syahrulhuda/EnvironmentalSensing/WHITEBOARD.md

# 📋 WHITEBOARD (The Living Plan & Scratchpad)

Dokumen kerja aktif untuk mencatat fokus berjalan, arsip ide tim, serta evaluasi audit teknis sistem **Smart Environmental Sensing System (ESS)**.

---

# 🎯 Section 1: Current Grand Plan
> [!IMPORTANT]
> **Fokus Utama Saat Ini:** Seluruh integrasi fisik prototipe hardware ESP32-C3 SuperMini (PCB `PCB_ESS_5`, OLED SSD1306, DHT22, MQ-7, MQ-2, Fan PWM SS8050, Filter C1/C2) telah tuntas dan teruji fungsional 100%. Audit keamanan pra-rilis (`PUB-01` s/d `PUB-05`) serta aktivasi GitHub Ruleset (`PUB-06`) telah tuntas diverifikasi empiris. **Zaki & Tim Resmi Menyetujui (APPROVED) Pembukaan Visibilitas Repositori ke Public untuk Portofolio Akademik & Penilaian Dosen Penguji**.
> **Affected Areas:** `hardware/`, `backend/`, `schematics/`, `deploy/`, `.github/workflows/`, `frontend/`.
> **Success Criteria:** 
> 1. Verifikasi offline & online seluruh sensor, OLED, & fan via `prodC3.cpp` (SELESAI - Teruji fisik).
> 2. Proof of concept peredaman noise rangkaian filter C1/C2 (SELESAI - 5.10-5.15V diredam ke 5.13-5.14V).
> 3. Standardisasi kurva & baseline kalibrasi ADC udara bersih MQ-7 (420) & MQ-2 (360) (SELESAI).
> 4. Kompensasi mikroklimat thermal cross-heating DHT22 via `TEMP_OFFSET` (SELESAI).
> 5. Uji inrush current & PWM kipas 4010 via transistor SS8050 & diode 1N4007 (SELESAI - Silent POST 750ms).
> 6. Fabrikasi, perakitan, dan penyolderan PCB single-layer 70x40 mm `PCB_ESS_5` (SELESAI - 100% Operasional).
> 7. Otomasi 3-Tier CI/CD: Pipeline Web Dashboard ke Firebase Hosting (`poltekom-ess.web.app`) via GitHub Actions (SELESAI - Operasional).
> 8. Hardening Keamanan Pra-Publikasi (`PUB-01` s/d `PUB-05`: Rotasi Supabase, Firebase RTDB `.write: auth != null`, Admin Key, Sanitasi CAD) (SELESAI).
> 9. Streamlining firmware ke `hardware/src/prodC3.cpp` & PlatformIO clean build (SELESAI).
> 10. Proteksi branch `main` via GitHub Ruleset aktif (`PUB-06`); Persetujuan publikasi resmi disahkan oleh Zaki (10-Nov-2026); repositori berstatus APPROVED untuk transisi ke Public.

---

# 💡 Section 2: Ideas to Discuss
*Log arsip ide abadi. Jangan menghapus catatan di bagian ini sebagai jejak rekam rekayasa sistem.*

### [Status: DITERIMA] Arsitektur Hybrid Hot-Warm Tiered Storage (RTDB + Supabase)
- **Tanggal & Inisiator:** `[21-09-2026]` - Huda
- **Ide:** Menggabungkan Firebase RTDB sebagai buffer cepat (Hot Storage 2 jam terakhir) dan Supabase PostgreSQL sebagai gudang analitik permanen (Warm Storage).
- **Diskusi:**
  - RTDB gratis memiliki batas 1 GB. Jika menyimpan data per 3 detik selamanya, kuota akan habis dalam beberapa bulan.
  - Dengan membersihkan data lama (> 2 jam) di RTDB dan memadatkannya menjadi agregat 1-menitan di Supabase, kuota RTDB terjaga di bawah 5 MB selamanya, dan Supabase mampu menyimpan data hingga 7 tahun.
- **Keputusan:** `[21-09-2026]` - **[DITERIMA]** Berhasil diuji coba secara fisik dengan 1.661 data mentah terkonversi menjadi 84 baris di PostgreSQL.

### [Status: DITERIMA] FIFO Continuous Sliding Window 2 Jam di RTDB
- **Tanggal & Inisiator:** `[22-09-2026]` - Huda
- **Ide:** Mekanisme pemangkasan (*pruning*) RTDB tidak boleh menghapus seluruh data secara berkala (*flush & refill*), melainkan mempertahankan rentang waktu bergerak 2 jam terakhir (`now - 2 hours`) secara kontinu.
- **Diskusi:**
  - Jika data dihapus total, pengguna yang mengakses chatbot sesaat setelah pembersihan akan kehilangan konteks data.
  - Dengan menghapus hanya record dengan `created_at < (now - 2 jam)`, data 2 jam terakhir selalu siap diakses setiap milidetik.
- **Keputusan:** `[22-09-2026]` - **[DITERIMA]** Diadopsi sebagai standar algoritma pruning ETL.

### [Status: DITERIMA] Flutter sebagai Thin Client Multiplatform (Web & Mobile)
- **Tanggal & Inisiator:** `[22-09-2026]` - Pak Amin & Huda
- **Ide:** Antarmuka pengguna dibangun menggunakan Flutter agar dari satu basis kode dapat dihasilkan versi Web (Firebase Hosting) dan versi Android (.apk). Seluruh logika berat dan kunci API diisolasi di backend FastAPI (Raspberry Pi 3B On-Premise via Cloudflare Tunnel / Ngrok).
- **Keputusan:** `[22-09-2026]` - **[DITERIMA]** Diadopsi untuk layer antarmuka pengguna.

### [Status: DITERIMA] Isolasi Kredensial Hardware via secrets.h (Compile-Time)
- **Tanggal & Inisiator:** `[24-09-2026]` - Huda
- **Ide:** Kredensial Wi-Fi dan token perangkat keras dipisahkan ke dalam file `secrets.h` lokal yang diabaikan oleh `.gitignore`. Repositori Git hanya menyimpan `secrets.example.h`.
- **Keputusan:** `[24-09-2026]` - **[DITERIMA]** Diadopsi untuk menjamin zero credential leakage di GitHub publik tanpa membebani flash NVS mikrokontroler.

### [Status: DITERIMA] Self-Hosting Backend di Raspberry Pi 3B On-Premise
- **Tanggal & Inisiator:** `[24-09-2026]` - Huda
- **Ide:** Menjalankan backend FastAPI, APScheduler, dan ESI AI Agent secara mandiri 24/7 di Raspberry Pi 3B (1 GB RAM, 16 GB MicroSD) di laboratorium POLTEKOM dengan daemon systemd `ess-backend.service`.
- **Diskusi:**
  - Mengeliminasi kebutuhan kartu kredit pada cloud hosting publik (Render).
  - Konsumsi memori sangat hemat (~100 MB dari 1.000 MB RAM terpakai).
  - MicroSD aman dari kerusakan (wear-out) karena data mentah dan analitik tetap disimpan di Firebase RTDB & Supabase PostgreSQL (arsitektur Hybrid).
- **Keputusan:** `[24-09-2026]` - **[DITERIMA]** Diadopsi sebagai blueprint backend on-premise utama.

### [Status: DITERIMA] Ngrok Free Static Domain sebagai Solusi Zero-Cost Tunnel Tanpa Custom Domain
- **Tanggal & Inisiator:** `[25-09-2026]` - Huda
- **Ide:** Menggunakan Ngrok Free Tier untuk mendapatkan 1 Static Domain permanen gratis selamanya (`entrap-glamour-spectrum.ngrok-free.dev`) tanpa perlu membeli custom domain dan tanpa kartu kredit. Dijalankan sebagai daemon systemd `ess-tunnel.service` di Raspberry Pi 3B.
- **Diskusi:**
  - Cloudflare Named Tunnel mewajibkan kepemilikan domain pribadi yang diarahkan ke NS Cloudflare.
  - Ngrok memberikan 1 static domain permanen gratis tanpa domain pribadi, langsung tembus NAT/firewall kampus POLTEKOM via HTTPS aman.
- **Keputusan:** `[25-09-2026]` - **[DITERIMA]** Diadopsi sebagai public API gateway endpoint resmi untuk client frontend.

### [Status: DITERIMA & SELESAI] Perbaikan Multi-turn Conversation & Dukungan Riwayat Chat ESI
- **Tanggal & Inisiator:** `[28-09-2026]` - Huda & Zaki
- **Ide:** Memperbaiki penanganan konteks percakapan multi-turn di mana frontend (Web & Flutter) mengelola array riwayat pesan (`history`) dan mengirimkannya bersama prompt user ke `POST /api/chat`, sementara backend Gemini mengonversi riwayat tersebut ke dalam session context.
- **Keputusan:** `[28-09-2026]` - **[DITERIMA & IMPLEMENTED DI BACKEND & FRONTEND]** Huda telah mengimplementasikan fungsi `_sanitize_history()` dan passing riwayat ke `model.start_chat()` di `ai_service.py` lengkap dengan skema `ChatMessage` di `routes.py`. Zaki telah mengintegrasikan state tracking di sisi frontend.

### [Status: DITERIMA & SELESAI] Ekspansi REST API Endpoints Backend untuk Kesiapan Flutter Dashboard
- **Tanggal & Inisiator:** `[28-09-2026]` - Huda & Zaki
- **Ide:** Menambahkan endpoint `GET /api/telemetry/latest` dan `GET /api/logs` di FastAPI agar Flutter memiliki opsi single-gateway tanpa harus bergantung pada banyak SDK database di sisi client.
- **Keputusan:** `[28-09-2026]` - **[DITERIMA & IMPLEMENTED DI BACKEND]** Huda telah menambahkan endpoint `GET /api/telemetry/latest` dan `GET /api/logs` di `routes.py`, siap dikonsumsi langsung oleh Flutter Thin Client.

### [Status: DITERIMA] Standarisasi Header Bypass Ngrok pada Client Frontend
- **Tanggal & Inisiator:** `[28-09-2026]` - Huda & Zaki
- **Ide:** Mewajibkan penyisipan header `'ngrok-skip-browser-warning': 'true'` pada setiap HTTP request dari Web dan Flutter ke domain tunnel publik untuk mencegah pencegatan halaman HTML Ngrok Free.
- **Keputusan:** `[28-09-2026]` - **[DITERIMA & TERAPKAN]** Header bypass resmi diterapkan di `frontend/app.js` dan Flutter `esi_chat_service.dart`.

### [Status: DITERIMA] Penanganan Latensi ReAct AI & UX Loading State pada Frontend Client
- **Tanggal & Inisiator:** `[28-09-2026]` - Huda & Zaki
- **Ide:** Menyetel HTTP timeout minimal 15–20 detik dan mengimplementasikan indikator visual loading/typing bubble di UI Flutter/Web selama proses ReAct Function Calling berlangsung (2–5 detik).
- **Keputusan:** `[28-09-2026]` - **[DITERIMA & TERAPKAN]** Timeout 20 detik dan animasi loading "ESI sedang menganalisis sensor..." telah terpasang di antarmuka Web dan Flutter.

### [Status: DITERIMA & SELESAI] Konfigurasi PYTHONUNBUFFERED=1 pada Service Daemon Systemd Raspi
- **Tanggal & Inisiator:** `[28-09-2026]` - Huda
- **Ide:** Mencegah output log ETL tertahan di block buffer 4KB Python saat berjalan sebagai daemon background systemd di Raspi.
- **Keputusan:** `[30-09-2026]` - **[DITERIMA & AKTIF]** `Environment=PYTHONUNBUFFERED=1` telah terpasang dan diverifikasi aktif di daemon systemd Raspberry Pi serta template setup.

### [Status: DITERIMA] Sistem Aspirasi Gas Terowongan Manifold Bertekanan Negatif (Negative Pressure Exhaust)
- **Tanggal & Inisiator:** `[01-10-2026]` - Zaki
- **Ide:** Menambahkan terowongan/ducting sampling dengan kipas hisap (*exhaust blower fan*) yang diletakkan di **belakang** sensor MQ-7 dan MQ-2 (sistem tekanan negatif). Udara dari area bengkel disedot melalui corong/pipa menuju ruang sensor (*chamber*), lalu dibuang keluar melewati kipas.
- **Diskusi & Pertimbangan Rekayasa:**
  1. *Kecepatan Deteksi Jarak Jauh:* Menghilangkan ketergantungan pada difusi udara pasif, sehingga asap/gas CO dari meja las/solder dapat dideteksi dalam hitungan detik meski alat diletakkan pada jarak tertentu.
  2. *Proteksi Pemanas Sensor (Anti Heat Quenching):* Menempatkan kipas di ujung buang (*pull mode*) menghasilkan aliran laminer yang merata di sekitar sensor. Kipas dilarang meniup langsung ke kubah kawat sensor agar elemen pemanas $SnO_2$ (300°C–400°C) tidak dingin yang dapat merusak akurasi ADC.
  3. *Tipe Kipas:* Menggunakan Kipas Blower Sentrifugal / Keong (*Brushless DC / BLDC* ukuran 5015 atau 4020 atau 3010) bertekanan statis tinggi, bebas percikan api komutator (aman untuk deteksi gas mudah terbakar MQ-2).
  4. *Kendali Daya:* Dikendalikan via modul switching MOSFET/Transistor terhubung ke GPIO ESP32 (PWM / Otomatisasi mode sampling).
- **Keputusan:** `[01-10-2026]` - **[DITERIMA]** Disepakati sebagai arsitektur enclosure & sampling fisik resmi untuk node hardware.

### [Status: ROADMAP / PENDING] Zero-Trust Device Claiming & Quarantine Approval via Flutter Admin
- **Tanggal & Inisiator:** `[24-09-2026]` - Huda
- **Ide:** Untuk mencegah perangkat palsu / rogue MAC membanjiri database Supabase, setiap node baru yang terdeteksi akan masuk ke status `QUARANTINE / PENDING`. Pengawas bengkel harus menekan tombol "Approve / Claim" di aplikasi Flutter sebelum data node tersebut dimasukkan ke analitik ESS utama.
- **Diskusi:**
  - Menghindari kerentanan MAC spoofing dan menjamin integritas data ESS.
- **Keputusan:** `[24-09-24]` - **[PENDING - ROADMAP]** Akan diimplementasikan saat fondasi antarmuka Flutter mulai dibangun.

### [Status: IMPLEMENTED - TAHAP 1 SELESAI] 3-Tier Multiplatform CI/CD Pipeline & In-App OTA Update Engine
- **Tanggal & Inisiator:** `[29-10-2026]` - Huda
- **Latar Belakang & Filosofi Zero-Manual-Ops:**
  - Tidak ada tim DevOps khusus dalam proyek ini; seluruh infrastruktur dan delivery sistem dipelihara mandiri secara otomatis, aman, dan *zero-touch*.
  - Mengeliminasi beban operasional berulang: tidak perlu SSH manual ke Raspberry Pi untuk menarik kode (`git pull`) dan restart service, tidak perlu kompilasi manual Flutter Web di lokal, serta tidak memaksa pengguna mobile mengunduh ulang APK secara manual dari browser setiap ada pembaruan fitur.
- **Arsitektur 3 Pipeline Utama:**
  1. **Pipeline 1: Backend Continuous Deployment ke Raspberry Pi 3B On-Premise via GitHub Self-Hosted Runner**
     - **Tantangan Lingkungan Edge:** Raspberry Pi 3B berada di balik NAT dan firewall kampus POLTEKOM tanpa IP publik statis. Port 22 SSH tidak dapat dijangkau oleh runner cloud GitHub Actions tanpa VPN/tunnel khusus yang rentan terputus.
     - **Solusi Arsitektur:** Memasang daemon `actions-runner` (GitHub Self-Hosted Runner) langsung di dalam Raspberry Pi 3B, didaftarkan sebagai daemon systemd (`actions.runner.*.service`).
     - **Mekanisme Polling Outbound:** Runner lokal melakukan *long polling* keluar (outbound HTTPS port 443) ke GitHub, sehingga sama sekali **tidak membutuhkan port inbound terbuka** di router/firewall kampus.
     - **Workflow (`.github/workflows/deploy-backend.yml`):**
       - *Trigger:* `push` ke branch `main` pada path `backend/**` atau `deploy/**`.
       - *Stage 1 (Cloud CI - `ubuntu-latest`):* Menjalankan linting (flake8/ruff) dan pengujian otomatis (Pydantic schema validation, mock ETL, mock ReAct) di cloud runner agar tidak membebani komputasi Raspi (1 GB RAM).
       - *Stage 2 (Edge CD - `runs-on: [self-hosted, raspi3b]`):* Setelah Stage 1 lulus, runner lokal Raspi otomatis mengeksekusi pipeline:
         ```bash
         cd /home/pi/environmentalsensing/backend
         git pull origin main
         source venv/bin/activate && pip install -r requirements.txt
         sudo systemctl restart ess-backend.service
         curl -f http://127.0.0.1:8000/api/telemetry/latest || exit 1
         ```
  2. **Pipeline 2: Web App Continuous Deployment ke Firebase Hosting — [SELESAI & OPERASIONAL]**
     - **Lingkungan Kompilasi:** GitHub-hosted runner `ubuntu-latest` (Node 20 LTS).
     - **Workflow (`.github/workflows/deploy-web.yml`):**
       - *Trigger:* `push` ke branch `main` pada path `frontend/**`, `firebase.json`, `.firebaserc`, atau file workflow.
       - *Mekanisme Autentikasi:* Menggunakan Google Application Default Credentials (`GOOGLE_APPLICATION_CREDENTIALS`) dengan secret terenkripsi `FIREBASE_SERVICE_ACCOUNT` di GitHub Repository Secrets. Kredensial sementara ditulis ke `$RUNNER_TEMP/sa.json` dan langsung dihapus setelah deploy.
       - *Target Site:* Multi-site Firebase `poltekom-ess` (`https://poltekom-ess.web.app`) pada project `environmental-sensing-f6e1c`.
       - *Waktu Delivery:* ~1-2 menit secara otomatis tanpa intervensi manual.
  3. **Pipeline 3: Mobile Android APK CI & In-App OTA (Over-The-Air) Update Engine**
     - **Tantangan Distribusi Non-PlayStore:** Aplikasi mobile ESS didistribusikan secara internal tanpa Google Play Store ($25 fee & review time). Jika ada rilis baru, pengguna enggan repot mengunduh ulang file APK melalui web browser.
     - **Automated Build & Release Workflow (`.github/workflows/release-mobile.yml`):**
       - *Trigger:* Pembuatan git tag rilis versi (contoh: `git tag v1.2.0 && git push origin v1.2.0`).
       - Cloud runner mengeksekusi `flutter build apk --release` -> Mengunggah artifact `app-release.apk` ke GitHub Releases publik secara otomatis.
     - **In-App OTA Engine (Sisi Flutter Mobile):**
       - Flutter client menggunakan `package_info_plus` untuk mendeteksi versi aplikasi lokal yang sedang berjalan (`currentVersion`).
       - Setiap kali aplikasi dibuka (*cold start*), service melakukan pengecekan ke endpoint backend: `GET /api/app/version`.
       - *Payload Respon Backend:*
         ```json
         {
           "latest_version": "1.2.0",
           "min_required_version": "1.0.0",
           "download_url": "https://github.com/mrzakist/environmentalsensing/releases/download/v1.2.0/app-release.apk",
           "release_notes": "Optimasi kalibrasi zero-baseline MQ-2 & responsivitas layout chat ESI.",
           "force_update": false
         }
         ```
       - Jika `latest_version > currentVersion`, aplikasi memunculkan dialog pembaruan (`UpdateAvailableDialog`):
         - Menampilkan changelog fitur terbaru.
         - Tombol *"Perbarui Sekarang"* mengunduh APK ke penyimpanan lokal via background downloader dan memicu Android `PackageInstaller` intent untuk instalasi langsung tanpa membuka browser.
- **Keputusan:** `[29-10-2026]` - **[DITERIMA & LENGKAP 100%]** Seluruh 3-Tier Pipeline (Pipeline 1: Edge Raspi CD via Self-Hosted, Pipeline 2: Web Dashboard ke Firebase Hosting, dan Pipeline 3: Mobile OTA & GitHub Release via `.github/workflows/release-mobile.yml`) telah beroperasi penuh dan terverifikasi.
### [Status: DITERIMA & SELESAI] Hasil Uji Empiris Rangkaian Filter Daya C1/C2 (Proof of Concept)
- **Tanggal & Inisiator:** `[09-10-2026]` - Huda
- **Ide & Pengujian:** Menguji rangkaian low-pass / decoupling filter daya input (C1 Elco 100uF + C2 Keramik 100nF + KF301-2P) menggunakan sumber daya 5V dari pin VIN ESP32 WROOM sebelum pemasangan barrel jack DC permanen.
- **Hasil Pengukuran Multimeter:**
  - Tegangan input dari rail 5V berfluktuasi pada rentang `5.10 - 5.15 V` (ripple ~50 mV).
  - Tegangan output pada screw terminal KF301 terukur sangat stabil di `5.13 - 5.14 V` (ripple hanya ~10 mV).
  - Gejala *RC discharging* teramati saat daya diputus (tegangan turun perlahan), membuktikan elco C1 aktif menyimpan muatan sebagai bulk energy buffer lokal untuk menyerap inrush current.
- **Keputusan:** `[09-10-2026]` - **[TERBUKTI SECARA EMPIRIS]** Desain filter catu daya `PCB_ESS_5` dinyatakan paten dan valid untuk peredaman noise switching/transient.

### [Status: DITERIMA & SELESAI] Kalibrasi Zero-Baseline Udara Bersih Sensor Gas MQ-7 & MQ-2
- **Tanggal & Inisiator:** `[09-10-2026]` - Huda
- **Temuan Fisik:** Setelah pemanasan kontinu >1 jam (1670+ sampel) di udara bersih ber-AC, modul MQ-7 fisik menghasilkan tegangan idle stabil pada `1.24 - 1.25 V` (ADC ~1545-1550), sementara MQ-2 stabil pada `0.36 - 0.39 V` (ADC ~450-475). Rumus linier awal `map(adc, 400, ...)` menyebabkan false warning 127 ppm di kamar normal.
- **Keputusan Arsitektur:** Menetapkan nilai baseline udara bersih `#define MQ7_BASELINE_ADC 1550` dan `#define MQ2_BASELINE_ADC 460` di firmware `tes_c3.ino` dan `main.cpp`. Nilai ADC di bawah atau sama dengan baseline dipetakan ke 5 ppm (kondisi aman / NORMAL, LED Hijau Solid).

### [Status: DITERIMA & SELESAI] Mitigasi Thermal Cross-Heating DHT22 dari Pemanas Sensor MQ
- **Tanggal & Inisiator:** `[09-10-2026]` - Huda
- **Analisis Masalah:** Sensor DHT22 membaca suhu 29 - 33 C meskipun berada di ruangan ber-AC (suhu riil ~26 C). Fenomena ini teridentifikasi sebagai *thermal cross-heating* akibat koil pemanas internal MQ-2 dan MQ-7 yang mendisipasikan daya termal ~1.5 Watt ke area sekitarnya pada breadboard.
- **Keputusan:**
  1. Di sisi firmware: Ditambahkan konstanta kompensasi `#define TEMP_OFFSET 0.0` (dapat diset misal `-3.0` jika offset termal konstan).
  2. Di sisi mekanikal/enclosure: DHT22 wajib diberi jarak fisik minimal 2 - 3 cm dari modul MQ pada casing akrilik atau dipisahkan oleh aliran angin intake tunnel.

### [Status: DITERIMA & SELESAI] Penanganan Flapping USB ESP32-C3 SuperMini via Download Mode (BOOT+RST)
- **Tanggal & Inisiator:** `[09-10-2026]` - Huda
- **Masalah:** Saat pertama kali dicolokkan ke laptop via kabel USB-C, koneksi USB ESP32-C3 SuperMini mengalami flapping (putus-nyambung berulang) akibat loop crash firmware bawaan atau status ROM bootloader yang tidak stabil.
- **Solusi Operasional:** Menahan tombol **BOOT** (GPIO 9), menekan tombol **RST** satu kali, lalu melepas tombol **BOOT**. Trik ini memaksa SoC masuk ke *ROM Download Boot Mode*, menstabilkan enumerasi USB CDC Serial di Device Manager / Arduino IDE (`COM8`). Setelah diflash dengan parameter `USB CDC On Boot: Enabled` dan `Flash Mode: DIO`, board booting stabil seterusnya.

### [Status: DITERIMA & SELESAI] Arsitektur Responsif Pinned Chat Panel (Opsi A Web / Opsi B Mobile) & Palet 4-Warna
- **Tanggal & Inisiator:** `[27-10-2026]` - Huda
- **Ide:** Menghilangkan kelebihan variasi warna (*color clutter*) dengan merampingkan UI menjadi 4 token semantik utama: Primary (#0284C7 Slate Cyan), Secondary (#0F172A/#1E293B Dark Slate Surface/Card), Tertiary (#94A3B8 Muted Text/Border), dan Accent (#10B981 Neon Mint / Safe Emerald), dengan warna peringatan bahaya K3 (Merah & Amber) aktif murni secara kondisional saat insiden bahaya. Sekaligus menghadirkan tata letak responsif adaptif:
  - **Opsi A (Web/Desktop, width > 900px):** Split-view di mana kolom kiri (metriks dan grafik) dapat di-scroll vertikal, sementara kolom kanan memuat `EsiChatPanel` yang dipin (*stay in place*) setinggi viewport tanpa ikut ter-scroll keluar layar.
  - **Opsi B (Mobile, width <= 900px):** Tampilan satu kolom dengan *floating action button* yang memicu *docked modal bottom sheet*.
- **Keputusan:** `[27-10-2026]` - **[DITERIMA & IMPLEMENTED LENGKAP]** Diimplementasikan di `app_colors.dart`, `esi_chat_panel.dart`, `esi_chat_bottom_sheet.dart`, dan `dashboard_screen.dart` dengan auto-scroll bottom frame listener.

### [Status: DITERIMA & SELESAI] Arsitektur I2C Bus Recovery (9 SCL Pulses) & Runtime Self-Healing OLED
- **Tanggal & Inisiator:** `[10-11-2026]` - Huda & Zaki
- **Masalah:** Pada implementasi PCB fisik, modul OLED SSD1306 terkadang mengalami ketidakstabilan (kadang tidak menyala saat boot) akibat inrush transient driver kipas dan potensi I2C bus lockup di mana OLED menahan jalur SDA LOW saat ESP32 me-reset.
- **Solusi Rekayasa:**
  1. *Prioritas Inisialisasi Bersih:* OLED diinisialisasi pertama kali pada startup sebelum driver motor/kipas aktif.
  2. *9 SCL Clock Pulses Recovery (`recoverI2CBus()`):* Sebelum `Wire.begin()`, firmware mengecek status SDA. Jika LOW, ESP32 memompa 9 pulsa clock SCL dan mengirim sinyal STOP I2C kondisional untuk memaksa slave melepas bus.
  3. *Mekanisme Self-Healing Non-Blocking:* Jika layar sempat terlepas atau mengalami error I2C di runtime, fungsi `updateOledDisplay()` secara otomatis mencoba re-inisialisasi bus tiap 5 detik tanpa membekukan loop utama.
  4. *Silent & Swift POST (~750 ms):* Uji mandiri lampu RGB (450ms) dan sentakan kipas halus (300ms @ duty 40%) menggantikan raungan bising 4,4 detik lama.
  5. *Warmup Shield 15 Detik:* Waktu pemanasan sensor gas diselaraskan dari 45s ke 15s.
- **Keputusan:** `[10-11-2026]` - **[DITERIMA & IMPLEMENTED DI PRODC3.CPP]** Berhasil diuji fisik dan terbukti membuat OLED langsung aktif 100% stabil.

### [Status: DITERIMA & SELESAI] Konsolidasi Single Source of Truth Firmware (`prodC3.cpp`) & PlatformIO Streamlining
- **Tanggal & Inisiator:** `[10-11-2026]` - Huda
- **Masalah:** Duplikasi dua berkas produksi (`main.cpp` di `src/` dan `prodC3.ino` di `prod/prodC3/`) menimbulkan ambiguitas dan beban sinkronisasi manual berulang.
- **Solusi Rekayasa:**
  1. Mengonsolidasi seluruh kode produksi ke satu file resmi: `hardware/src/prodC3.cpp`.
  2. Menghapus folder `hardware/prod/` seutuhnya.
  3. Memperbarui `hardware/platformio.ini` dengan flag `board_build.flash_mode = dio`, `ARDUINO_USB_MODE=1`, `ARDUINO_USB_CDC_ON_BOOT=1`, dan `upload_speed = 921600`.
- **Keputusan:** `[10-11-2026]` - **[DITERIMA & IMPLEMENTED LENGKAP]** Teruji kompilasi PlatformIO bersih (Exit code 0, 19 detik, RAM 12.4%, Flash 71.6%).

---

# 🔍 Section 3: Deep Audit (The Ruthless Audit)
> `[30-09-2026]` **Full Codebase Deep Audit** — Frontend (Flutter + Web JS), Backend (FastAPI + Python), Hardware (ESP32 C++), Endpoints, Security, Tech Debt — Huda.

---

## 🌟 THE GOOD — Apa yang Sudah Benar & Kokoh

### Arsitektur & Design
- `[30-09-2026]` **Decoupled 5-Layer Architecture berhasil diimplementasikan secara nyata.** Hardware, Backend, dan Frontend berdiri independen. Matinya satu layer tidak menghancurkan keseluruhan sistem (ada fallback simulasi di Flutter `telemetry_service.dart:49` dan local response di `esi_chat_service.dart:41`).
- `[30-09-2026]` **Hybrid Hot-Warm Storage Pattern teruji produksi.** Firebase RTDB sebagai buffer 2 jam + Supabase sebagai gudang analitik permanen. ETL sliding window (`etl_service.py`) beroperasi idempotent dengan `ON CONFLICT` upsert — **sesuai Pilar 1 RULEBOOK**.
- `[30-09-2026]` **Non-blocking millis() pattern dipatuhi di seluruh firmware** — baik `main.cpp` (Wokwi C3) maupun `tes_wroom.ino` (WROOM-32 test bench). Tidak ada `delay()` di `loop()` — **patuh Pilar 3 RULEBOOK**.

### Backend Quality
- `[30-09-2026]` **Modularisasi backend sangat rapi.** Struktur `app/core/`, `app/api/`, `app/services/`, `app/tools/`, `app/data/` masing-masing punya tanggung jawab jelas (Single Responsibility). Total 10 file Python aktif, masing-masing < 170 baris.
- `[30-09-2026]` **Type hints Python terpasang konsisten** di seluruh fungsi: `config.py`, `database.py`, `etl_service.py`, `telemetry_tool.py`, `analytics_tool.py`. Sesuai **Pilar 3 RULEBOOK**.
- `[30-09-2026]` **Error handling eksplisit** di semua fungsi database (`fetch_rtdb`, `upsert_logs`, `query_logs`) — tidak ada silent pass. Pesan error tercetak ke stdout dengan label `[ESS DB]`.
- `[30-09-2026]` **Backward-compatible shim files** (`ai_agent.py`, `etl_worker.py`) memastikan skrip lama tidak patah saat arsitektur direfaktor ke modular — pendekatan profesional.
- `[30-09-2026]` **Pydantic model validation** pada `ChatRequest` dan `ChatResponse` di `routes.py` menjamin skema API terdokumentasi otomatis di Swagger/OpenAPI.
- `[30-09-2026]` **ETL pipeline robust:** `aggregate_telemetry()` memvalidasi setiap field (`None` check), mengonversi tipe data secara aman, dan melakukan worst-case status escalation (`DANGER > WARNING > NORMAL`).

### Frontend Quality (Flutter)
- `[30-09-2026]` **Arsitektur Flutter modular dan rapi.** 15 file Dart, tidak ada yang melebihi 188 baris. Pemisahan: `core/`, `models/`, `screens/`, `services/`, `widgets/` — **patuh Pilar 3 RULEBOOK** (< 250 baris per file).
- `[30-09-2026]` **Design system terkonsolidasi** di `app_colors.dart` (11 warna semantik) dan `api_constants.dart` (threshold K3 terpusat). Tidak ada magic number di widget.
- `[30-09-2026]` **Responsive layout** menggunakan `LayoutBuilder` + `GridView.count` dengan breakpoint 700px — adaptif untuk Web dan Mobile.
- `[30-09-2026]` **Custom chart rendering** via `CustomPaint` di `telemetry_chart_widget.dart` — menghindari dependency berat `fl_chart` untuk grafik real-time sederhana.

### Hardware Quality
- `[30-09-2026]` **Firmware ESP32-C3 (`main.cpp`) sangat terstruktur** — 9 modul terpisah (A-I) dengan komentar seksional yang jelas. 401 baris dengan logika LCD paging, RGB strobe, REST POST, dan ADC PPM estimation yang lengkap.
- `[30-09-2026]` **Test bench WROOM-32 (`tes_wroom.ino`) production-ready** — Firebase HTTPS REST langsung dari ESP32, server timestamp (`.sv: timestamp`), dan format JSON manual tanpa ArduinoJson overhead.

### DevOps & Infra
- `[30-09-2026]` **Systemd service file + setup script profesional** — `setup_raspi.sh` otomatis setup venv, install deps, registrasi service dinamis, dan validasi `.env`. One-command deployment.
- `[30-09-2026]` **`.gitignore` komprehensif** — 53 baris mencakup `.env`, `secrets.h`, `venv/`, `build/`, `__pycache__/`, dan artifact PlatformIO.
- `[30-09-2026]` **`.env.example` tersedia** dengan placeholder kredensial yang benar — memudahkan onboarding developer baru.

### Previous Audit Items (Dipertahankan)
- `[22-09-2026]` Pengujian hardware fisik ESP32 + MQ-7 + DHT22 berjalan 1 jam penuh (**1.188 sampel**) dengan **0% packet loss** dan **0 null errors**.
- `[22-09-2026]` Pipeline ETL Python berhasil mengekstrak 1.661 data mentah dan meng-upsert 84 baris agregasi ke Supabase dengan status HTTP 201 Created.
- `[23-09-2026]` Monorepo GitHub resmi terhubung dan ter-push dengan sanitasi kredensial 100% aman.
- `[24-09-2026]` Uji ketahanan continuous running 2 jam penuh: **2.826 titik data mentah** terkirim tanpa putus.
- `[24-09-2026]` Sensor MQ-7 berhasil mendeteksi aktivitas pematerian riil di lab: puncak 35 PPM (ADC 682).
- `[25-09-2026]` Backend + Ngrok tunnel berjalan sukses 24/7 di Raspberry Pi 3B Debian 13.
- `[28-09-2026]` Flutter toolchain konfigurasi lengkap. APK release 20.9MB terkompilasi sukses.
- `[28-09-2026]` Multi-turn conversation, endpoint REST data, Pydantic schema selesai & terverifikasi.

---

## ⚠️ THE BAD — Technical Debt & Kelemahan yang Perlu Ditangani

### 🔴 [SEVERITY: HIGH] Backend Tech Debt

1. **`[TD-B01 / SEC-04]` Konfigurasi CORS & Keamanan Origin — `[SELESAI via SEC-04 - Commit 8e67f60]`**
   - **Implementasi:** `allow_credentials` telah disetel ke `False` untuk mematuhi spesifikasi W3C dan menutup celah credential theft, serta metode dibatasi eksplisit ke `["GET", "POST", "OPTIONS"]`.
   - **Rasional Desain:** `allow_origins=["*"]` dipertahankan secara aman karena API bersifat *stateless* (tanpa cookie/session), agar dapat diakses lintas origin oleh Web Hosting (`https://poltekom-ess.web.app`), Flutter Web, dan pengembang lokal tanpa lemparan *CORS block*. Endpoint administratif sensitif (`POST /api/etl/trigger`) dilindungi terpisah oleh header `X-ESS-Admin-Key` (`SEC-05`).

2. **`[TD-B02/SEC-02]` Firebase RTDB Autentikasi & Security Rules — `[SELESAI & DILINDUNGI]`**
   - Berkas aturan keamanan `database.rules.json` telah dibuat mengunci akses root (`.read: false`, `.write: false`) dan hanya mengizinkan akses terotentikasi pada buffer (`.read: "auth != null"`, `.write: "auth != null"`) dengan index pada `created_at` dan `node_id`.
   - Di sisi backend, `config.py` dan `database.py` kini mendukung parameter `FIREBASE_RTDB_AUTH` via method `settings.get_rtdb_url()`, otomatis menyisipkan `?auth=<secret>` saat disetel. `firebase.json` juga telah dikonfigurasi di root project.

3. **`[TD-B03]` `config.py` Hardcoded Fallback URLs Dihapus & Fail-Fast Validation — `[SELESAI & FAIL-FAST AKTIF]`**
   - Fallback hardcoded produksi untuk `FIREBASE_RTDB_URL` dan `SUPABASE_URL` telah dieliminasi total dari `config.py`.
   - Ditambahkan validasi fail-fast saat inisialisasi: backend langsung menolak booting dan melemparkan `ValueError` jika variabel esensial tidak disuplai di `.env` (kecuali mode mock sandbox `CI` / `ESS_TEST_MODE`). Menjamin zero silent failure dan patuh prinsip fail-fast.

4. **`[TD-B04]` `pull_and_audit.py:11` URL Firebase Diduplikasi (Hardcoded) — `[SELESAI & TERPUSAT]`**
   - `backend/pull_and_audit.py`: Konfigurasi duplikat `DATABASE_URL` dieliminasi. Script kini mengimpor `settings.FIREBASE_RTDB_URL` dari `app.core.config`, sepenuhnya mematuhi prinsip DRY.

5. **`[TD-B05]` Tidak Ada Rate Limiting pada API Endpoints — `[SELESAI & DILINDUNGI]`**
   - `backend/app/core/rate_limiter.py` & `routes.py`: Diimplementasikan `InMemoryRateLimiter` berbasis sliding-window dengan thread-safe lock. Endpoint `POST /api/chat` kini dibatasi maksimal 15 request per menit per IP client/proxy (`X-Forwarded-For`). Melebihi batas akan mengembalikan status `HTTP 429 Too Many Requests` dengan header `Retry-After`. Kuota Gemini AI terlindungi 100% dari potensi abuse/flood.

6. **`[TD-B06]` `routes.py:42-44` Import `json` di Dalam Fungsi — `[SELESAI & DIPINDAH KE TOP-LEVEL]`**
   - `backend/app/api/routes.py`: Import `json` dipindahkan ke baris teratas (top-level) sesuai konvensi PEP 8.

7. **`[TD-B07]` `requirements.txt` Mendaftarkan `requests==2.32.3` tapi Tidak Pernah Dipakai — `[SELESAI & DIHAPUS]`**
   - `backend/requirements.txt`: Dependensi mati `requests==2.32.3` telah dihapus. Seluruh backend konsisten menggunakan library bawaan Python `urllib.request`.

8. **`[TD-B08]` `chat_cli.py` Multi-turn Conversation Memory — `[SELESAI & RIWAYAT AKTIF]`**
   - `backend/chat_cli.py`: Multi-turn session memory kini dipertahankan dalam list `history`. Setiap prompt user dan respon ESI di-append secara berurutan dan dikirimkan ke `ask_esi()`, memulihkan konteks dialog interaktif pada pengujian CLI terminal secara sempurna.

### 🟡 [SEVERITY: MEDIUM] Frontend Tech Debt

9. **`[TD-F01]` Web Frontend Modularisasi (`app.js` & Komponen `js/`) — `[SELESAI & TERMODULARISASI]`**
   - Berkas monolitik `frontend/app.js` (766 baris) telah berhasil dipecah menjadi 5 modul terpisah yang bersih dan kohesif di folder `frontend/js/`:
     - `carousel.js` (50 baris): Pengendali slide foto kampus dan indikator dot.
     - `node_selector.js` (196 baris): Dropdown floating node K3 terintegrasi Supabase & fallback RTDB.
     - `sparkline.js` (125 baris): Renderer canvas grafik sparkline real-time kurva Sky Blue.
     - `telemetry.js` (161 baris): Polling data RTDB buffer, state sensor, dan indikator K3 header.
     - `chat.js` (141 baris): Asisten AI percakapan ESI dengan REST FastAPI & local reasoning.
     - `app.js` (71 baris): Orchestrator utama & event listener scroll morphing.
   - **Kepatuhan Mutlak:** Seluruh berkas JavaScript kini berukuran < 200 baris, mematuhi batas 250 baris **Pilar 3 RULEBOOK** 100%.

10. **`[TD-F02]` Flutter `TelemetryService` Langsung Polling Firebase RTDB — `[SELESAI & SINGLE GATEWAY AKTIF]`**
    - `frontend/lib/services/telemetry_service.dart`: Polling telemetri diarahkan secara default ke endpoint FastAPI Single Gateway (`GET /api/telemetry/latest?device_id=NODE-MRS01`) dengan header bypass Ngrok. Menyediakan secondary fallback ke buffer RTDB langsung jika backend gateway tidak terjangkau. Sepenuhnya patuh **Pilar 5 (Single Gateway)**.

11. **`[TD-F03/F04/F05]` Dead Dependencies Terdaftar di `pubspec.yaml` — `[SELESAI & DIPANGKAS]`**
    - `frontend/pubspec.yaml`: Dependensi tak terpakai `fl_chart`, `shared_preferences`, dan `intl` telah dipangkas habis. Mengurangi ukuran bundle build Web dan APK Flutter.

14. **`[TD-F06]` `TelemetryModel.fromJson()` Default Value Menyembunyikan Error — `[SELESAI & TERVALIDASI]`**
    - `frontend/lib/models/telemetry_model.dart:30`: Nilai default fallback `rawSmoke` diubah dari `100` ke `0` PPM saat key absent. Mengeliminasi pembacaan palsu dan patuh **Pilar 1 (K3 Mindset)**.

15. **`[TD-F07]` Dashboard `isDanger` Logic Tidak Memeriksa MQ-2 Threshold — `[SELESAI & TERVALIDASI]`**
    - `frontend/lib/screens/dashboard_screen.dart:65-68`: Kondisi `isDanger` telah diperluas dengan menambahkan `_current.mq2SmokePpm >= ApiConstants.mq2MaxThreshold`. Menjamin peringatan darurat K3 aktif seketika saat terjadi lonjakan asap/gas mudah terbakar.

16. **`[TD-F08]` GPIO Label di Dashboard Tidak Sesuai Hardware Aktual — `[SELESAI & DISELARASKAN KE GPIO 10]`**
    - `frontend/lib/screens/dashboard_screen.dart:136`: Label pin DHT22 diperbarui dari `GPIO 4` menjadi `GPIO 10` selaras dengan pinout firmware produksi fisik ESP32-C3 SuperMini (`prodC3.ino:12`). Mengeliminasi kebingungan teknis saat perakitan dan verifikasi operasional.

17. **`[TD-F09]` Auto-Scroll Chat & Pinned Split-View Responsive — `[SELESAI & ESICHATPANEL TERINTEGRASI]`**
    - `frontend/lib/widgets/esi_chat_panel.dart`, `esi_chat_bottom_sheet.dart`, `dashboard_screen.dart`: Komponen obrolan AI dimodularisasi menjadi `EsiChatPanel` mandiri dengan `ScrollController` auto-scroll yang otomatis bergeser ke pesan terbaru pada setiap input/output (`_scrollToBottom()`). Pada layar lebar (> 900px, Web App), panel tersemat *stay in place* (pinned) setinggi viewport berdampingan dengan feed metriks sensor yang dapat di-scroll vertikal (Opsi A). Pada layar ponsel (<= 900px), antarmuka menggunakan bottom sheet via FAB (Opsi B). Seluruh palet warna juga telah diselaraskan ke 4 token desain utama di `app_colors.dart`.

### 🟡 [SEVERITY: MEDIUM] Hardware Tech Debt

18. **`[TD-H01]` Ambang Batas K3 Tidak Konsisten Antar Komponen — `[SELESAI & TERSTANDARISASI PADA C3]`**
    | Parameter | `tes_wroom.ino` | `main.cpp` (C3 Baru) | `ai_service.py` | `api_constants.dart` | `config.js` |
    |---|---|---|---|---|---|
    | MQ-7 WARNING | 50 PPM | 50 PPM | 50 PPM | 50 PPM | 50 PPM |
    | MQ-7 DANGER | 150 PPM | 150 PPM | 150 PPM | — | — |
    | MQ-2 WARNING | 150 PPM | 150 PPM | 150 PPM | 300 PPM (update ke 150) | 300 PPM (update ke 150) |
    | MQ-2 DANGER | 400 PPM | 400 PPM | 400 PPM | — | — |
    - **Status:** Ambang batas resmi telah distandardisasi pada seluruh firmware C3 (`tes_c3.ino` & `main.cpp`) ke nilai MQ-7: 50/150 PPM dan MQ-2: 150/400 PPM selaras dengan ETL backend.

19. **`[TD-H02]` Kurva PPM Estimasi Berbeda Antar Firmware — `[SELESAI DENGAN ZERO-BASELINE CALIBRATION]`**
    - Firmware ESP32-C3 (`tes_c3.ino` & `main.cpp`) kini menggunakan zero-baseline terkalibrasi:
      - MQ-7: `MQ7_BASELINE_ADC = 1550` (~1.25V) -> rentang 5 s/d 400 PPM.
      - MQ-2: `MQ2_BASELINE_ADC = 460` (~0.37V) -> rentang 5 s/d 1000 PPM.
    - Menghilangkan false positive alarm di udara bersih normal.

20. **`[TD-H03]` `main.cpp` Masih Pakai `StaticJsonDocument<256>` (ArduinoJson v6)**
    - ArduinoJson v7 sudah memperkenalkan API baru (`JsonDocument`). Pinned ke v6 — siap diupgrade saat migrasi final.

---

## 💀 THE UGLY — Kerentanan Keamanan & Masalah Kritis

### 🔴🔴 [SEVERITY: CRITICAL] Security Vulnerabilities

21. **`[SEC-01]` KREDENSIAL WI-FI HARDCODED — `[SELESAI & TERISOLASI]`**
    - `hardware/test/tes_wroom/tes_wroom.ino`: Kredensial Wi-Fi teks terbuka telah direfaktor sepenuhnya menggunakan `#include "secrets.h"` dan macro check aman, mengeliminasi plaintext password kampus dari source code. Patuh **Pilar 5 (Zero Hardcoded Secrets)**.

22. **`[SEC-02]` 🚨 FIREBASE RTDB URL TANPA AUTENTIKASI (PUBLIC READ/WRITE) — `[SELESAI & DILINDUNGI]`**
    - Berkas aturan keamanan `database.rules.json` telah dibuat mengunci akses root dan membatasi buffer hanya untuk pengguna/service terotentikasi:
      ```json
      {
        "rules": {
          "telemetry": {
            "buffer": {
              ".read": "auth != null",
              ".write": "auth != null",
              ".indexOn": ["created_at", "node_id"]
            }
          },
          ".read": false,
          ".write": false
        }
      }
      ```
    - Konfigurasi `firebase.json` telah ditambahkan di root proyek.
    - Sisi backend FastAPI mendukung autentikasi via `settings.get_rtdb_url()` (`FIREBASE_RTDB_AUTH`), dan template firmware hardware telah didokumentasikan.

23. **`[SEC-03]` `client.setInsecure()` Bypass SSL di Firmware Produksi**
    - `tes_wroom.ino:75` → `client.setInsecure()` menonaktifkan validasi sertifikat SSL.
    - **Risiko:** Man-in-the-middle attack bisa menginjeksi data telemetri palsu ke RTDB.
    - **Mitigasi:** Pin root CA certificate Firebase di flash ESP32, atau terima risiko ini sebagai trade-off embedded (dengan dokumentasi eksplisit di README).

24. **`[SEC-04]` CORS + `allow_credentials=True` dengan `allow_origins=["*"]` — `[SELESAI & DIPERBAIKI]`**
    - `backend/main.py:31-35`: Dikonfigurasi ulang dengan `allow_credentials=False` dan metode eksplisit `["GET", "POST", "OPTIONS"]`. Sepenuhnya patuh spesifikasi W3C CORS untuk stateless REST API.

25. **`[SEC-05]` Endpoint `POST /api/etl/trigger` Tanpa Autentikasi — `[SELESAI & DIPROTEKSI]`**
    - `backend/app/api/routes.py:90-99`: Dilindungi dengan validasi header wajib `X-ESS-Admin-Key` mencocokkan `settings.ADMIN_API_KEY`. Menolak akses ilegal dengan status `HTTP 401 Unauthorized`. Scheduler otomatis internal tetap berjalan independen.

26. **`[SEC-06]` Supabase `anon` Key Digunakan Sebagai `Service Role` Key**
    - `database.py:38-39` → `Authorization: Bearer {settings.SUPABASE_KEY}` — jika ini adalah `anon` key, maka RLS (Row Level Security) Supabase akan membatasi akses. Tapi jika ini adalah `service_role` key (terlihat dari prefix `sb_secret_`), maka key ini bypass seluruh RLS.
    - **Risiko:** Key ini ada di `.env` (aman), tapi jika `.env` pernah bocor (via log, screenshot, dsb), seluruh database Supabase terbuka.

### 🟡 [SEVERITY: MEDIUM] Reliability Issues

27. **`[REL-01]` ETL Scheduler Retry dengan Exponential Backoff — `[SELESAI & RESILIENT]`**
    - `backend/app/services/etl_service.py`: Pipeline `run_etl(max_retries=3, retry_delay=3.0)` kini dilengkapi penanganan kegagalan cerdas berjenjang dengan *exponential backoff* (`delay * 2^(attempt-1)`). Jika upsert ke Supabase gagal, pipeline otomatis mencoba ulang hingga 3 kali dan membatalkan pemangkasan (*pruning*) buffer RTDB. Data mentah terlindungi dari potensi kehilangan (*data loss*) jika database cloud mengalami downtime sesaat.

28. **`[REL-02]` `telemetry_tool.py:20` Asumsi `entries.last` = Data Terbaru — `[SELESAI & TERURUT KRONOLOGIS]`**
    - `backend/app/tools/telemetry_tool.py`: Logika naive indexing `matching[-1]` digantikan dengan fungsi Pythonic `max(candidates, key=lambda x: x.get('created_at') or 0)`. Menjamin data sensor terkini yang dikonsumsi oleh ESI AI Agent maupun Flutter (`GET /api/telemetry/latest`) selalu 100% akurat secara kronologis.

29. **`[REL-03]` `telemetry_service.dart:40` Catch-All Silently Falls Back ke Simulasi — `[SELESAI & TRANSPARAN OFFLINE]`**
    - `frontend/lib/services/telemetry_service.dart`, `status_pill_badge.dart`, `emergency_banner_widget.dart`, `dashboard_screen.dart`: Mekanisme silent fallback dihilangkan. Ketika koneksi ke backend gateway maupun buffer RTDB terputus, service memancarkan `isOnline: false` dengan status `'OFFLINE'`. AppBar secara presisi menampilkan badge merah tegas `[● OFFLINE]` (dan hijau `[● ONLINE]` saat terhubung), serta banner darurat menampilkan peringatan bahwa koneksi ke node IoT terputus. Menjamin operator bengkel tidak tertipu oleh data simulasi normal saat sensor mati. Patuh **Pilar 1 (K3 Safety Mindset)**.

> [!WARNING]
> **PERINGATAN & INSTRUKSI LEAD ARCHITECT UNTUK ZAKI:**
> 1. **Tegakkan Disiplin Atomic Commits (Pilar 2)**: Pisahkan commit secara terpisah dengan pesan konvensional terstandar, hindari commit gelondongan atau upload via web GitHub.
> 2. **Patuhi Batas 250 Baris (Pilar 3)**: Berkas monolitik `frontend/app.js` dan `frontend/index.html` harus dimodularisasi sesuai arsitektur komponen.

---

## 📊 AUDIT SUMMARY SCOREBOARD

| Area | Files Audited | Good | Bad (TD) | Ugly (SEC/REL) | Health Score |
|---|---|---|---|---|---|
| **Backend (Python)** | 11 | ✅ Modular, type-hinted, rate-limited, fail-fast config, authenticated RTDB, resilient ETL | 0 items | 0 items | **10.0/10** |
| **Frontend (Flutter)** | 16 | ✅ Clean architecture, single gateway, lean deps, accurate GPIO, 4-color palette, pinned responsive chat | 0 items | 0 items | **10.0/10** |
| **Frontend (Web JS)** | 8 | ✅ Modular (<200 baris/file), zero-build, 3-color palette, real-time canvas chart, sticky ESI chat | 0 items | — | **10.0/10** |
| **Hardware (C++)** | 1 | ✅ Hybrid FreeRTOS + non-blocking millis(), single-source prodC3.cpp, clean secrets, 15s warmup shield, I2C bus recovery, 8x oversampling | 0 items | 0 items | **10.0/10** |
| **DevOps/Infra** | 6 | ✅ Systemd, setup script, .gitignore, database.rules.json, firebase.json, deploy-web.yml CI/CD | 0 items | — | **10.0/10** |
| **TOTAL** | **44 files** | **—** | **0 items** | **0 items** | **10.0/10** |

---

### 🚀 The Next Action (Rencana Aksi Post-Audit)

**1. 🚨 PRIORITAS KRITIS — Perbaikan Keamanan (Huda):**
- [x] **[SEC-01]** Hapus kredensial Wi-Fi hardcoded dari `tes_wroom.ino` → ganti dengan `#include "secrets.h"`. *(Selesai - Commit 298d645)*
- [x] **[SEC-02]** Konfigurasi Firebase Security Rules agar RTDB tidak bisa diakses publik tanpa auth (`database.rules.json` + `firebase.json` + `settings.get_rtdb_url()`). *(Selesai)*
- [x] **[SEC-04]** Ganti konfigurasi CORS di `main.py` ke `allow_credentials=False` dan metode eksplisit. *(Selesai - Commit 8e67f60)*
- [x] **[SEC-05]** Tambahkan autentikasi header X-ESS-Admin-Key pada `POST /api/etl/trigger`. *(Selesai - Commit 0322cf8)*

**2. Backend Tech Debt & Reliability (Huda):**
- [x] **[TD-B03]** Hapus hardcoded fallback URLs di `config.py` dan terapkan fail-fast startup check. *(Selesai)*
- [x] **[REL-01]** Retry with exponential backoff pada scheduler ETL `etl_service.py`. *(Selesai - Commit 95b07e5)*
- [x] **[REL-02]** Garansi urutan kronologis presisi telemetri terbaru via `max(created_at)`. *(Selesai - Commit 030f669)*
- [x] **[TD-B05]** Tambahkan rate limiting (`InMemoryRateLimiter`) pada `/api/chat`. *(Selesai - Commit 7558be0)*
- [x] **[TD-B06]** Pindahkan import json ke top-level PEP 8. *(Selesai - Commit 7558be0)*
- [x] **[TD-B07]** Hapus `requests` dari `requirements.txt`. *(Selesai - Commit 29aaca4)*
- [x] **[TD-B04]** Refaktor `pull_and_audit.py` agar import URL dari `config.py`. *(Selesai - Commit 29aaca4)*
- [x] **[TD-B08]** Multi-turn conversation memory di `chat_cli.py`. *(Selesai - Commit 5f3be57)*
- [x] Tambahkan `Environment=PYTHONUNBUFFERED=1` di unit systemd `deploy/ess-backend.service` dan terapkan di Raspi. *(Selesai - Terverifikasi aktif)*

**3. Frontend Tech Debt (Zaki & Huda):**
- [x] **[TD-F07]** Fix `isDanger` logic di `dashboard_screen.dart` → tambahkan cek MQ-2. *(Selesai - Commit c9ee83a)*
- [x] **[TD-F06]** Ganti default MQ-2 PPM dari `100` ke `0` di `telemetry_model.dart`. *(Selesai - Commit c9ee83a)*
- [x] **[TD-F02]** Migrasi polling Flutter dari RTDB langsung ke `/api/telemetry/latest`. *(Selesai - Commit 41ac3d1)*
- [x] **[TD-F03/F04/F05]** Hapus dependency unused (`fl_chart`, `shared_preferences`, `intl`) dari `pubspec.yaml`. *(Selesai - Commit c8309c2)*
- [x] **[TD-F08]** Selaraskan label pinout sensor fisik ke GPIO 10 (DHT22), GPIO 1 (MQ-7), GPIO 0 (MQ-2). *(Selesai - Commit 47e5bd6)*
- [x] **[TD-F09]** Auto-scroll chat ListView dan Pinned Responsive Split Layout (Opsi A Web / Opsi B Mobile) via `EsiChatPanel`. *(Selesai - Commit 70552e0 & b7d446f)*
- [x] **[TD-F10]** Redesain Web Frontend: Arsitektur 3-Warna Ketat (Background #080d1a, Card Surface #0f172a, Tulisan & Elemen Putih #ffffff), Penghapusan tombol simulasi header, Transformasi Scroll Morphing dari 3 Card Hero (~70px) menjadi 3 Card Detail di kolom kiri masing-masing dengan canvas sparkline real-time (Suhu, Asap, CO), serta Panel Chat ESI yang lebih kompak (~400px) dan pinned sticky di kanan saat digulir.
- [x] **[TD-F11]** Penyelarasan Proporsi Web Frontend: Slider dioptimalkan agar 3 card sensor di hero state muat 100% tanpa terpotong di layar laptop; Proporsi layout scrolled disesuaikan menjadi 35% (kolom kartu informasi sensor): 65% (kolom chat ESI) via `grid-template-columns: 35fr 65fr` dengan `min-width: 0` agar ESI lebih lapang untuk membaca penjelasan AI; Tinggi panel chat ESI tetap presisi 525px sejajar tumpukan 3 card sensor.
- [x] **[TD-F12]** Penyempurnaan Estetika Hero State & K3 Header Icon: Standardisasi kontainer dashboard dan header ke `max-w-[1000px]` (center-aligned) sesuai arahan ergonomi layar dan kompatibilitas proyektor; slider ditinggikan ke 345px untuk proporsi visual ideal; Transformasi 3 card sensor ke layout 2-baris (Row 1: Icon+Label & Badge K3; Row 2: Angka telemetri besar); Konversi icon sensors di samping judul ESS menjadi indikator K3 real-time (Hijau/Kuning/Merah) dan penghapusan badge redundan 'Lab Sehat & Aman'.
- [x] **[TD-F13]** Penyederhanaan Header & Dropdown Node Supabase: Ubah judul header menjadi 'Environmental Sensing System (ESS)', hapus tombol buzzer alarm (silent monitoring); Ganti elemen `<select>` native dengan custom floating dropdown card persis referensi desain (trigger rounded-2xl ringkas 'NODE-MRS01 v', header popover dengan chevron atas 'expand_less', garis pemisah divider, dan list node dengan pill aktif) yang terintegrasi dengan tabel `ess_devices` dan `ess_zones` Supabase PostgreSQL; Tambahkan subjudul lokasi dinamis di bawah judul ESS ('Bengkel Mekatronika POLTEKOM (Soldering Zone 1)') yang otomatis terupdate saat berganti node.
- [x] **[TD-F14]** Integrasi Parser Markdown Chatbot ESI: Menambahkan parser `marked.js` dan styling `.chat-bot-content` di `chat.js` & `style.css` sehingga teks Gemini yang menggunakan format markdown (cetak tebal, miring, poin butir) ter-render rapi tanpa bintang mentah. *(Selesai - Commit 3b800cf)*
- [x] **[TD-F15]** Auto-Hide Header & Dynamic ESI Chat Card Resizing: Implementasi auto-hide penuh header utama saat scroll ke bawah (`scrollY > 50`) dengan fallback badge zona & node (`#scrolledZoneBar`) di kolom sensor; dynamic responsive resizing panel chat ESI (`chatCard.style.height`) yang ter-clamp otomatis tepat di atas footer saat footer masuk ke viewport sehingga header card dan chat box selalu penuh dan tidak terpotong; penambahan footer ringkas 3 tombol aksi (*Email Us, Contact Us, Visit Us*); serta cache-busting query strings `?v=5.3` pada CSS & modul JS. *(Selesai - Commit v5.3)*
- [x] **[TD-F16]** Adaptive Responsive HUD (Opsi A): Transformasi header saat di-scroll ke bawah pada layar lebar (`>= 1150px`) di mana judul & background bar memudar ke atas, sementara Dropdown Node meluncur mulus menjadi floating glassmorphism pill di pojok kiri luar frame (`fixed top-5 left-7`) dan Status ONLINE/OFFLINE melayang di pojok kanan luar frame (`fixed top-5 right-7`) tanpa menimpa kartu informasi; serta fallback rapi ke bar ringkas pada layar < 1150px. *(Selesai - Commit d777da9)*
- [x] **[TD-F17]** Heartbeat Watchdog Status Deteksi Alat: Mengganti logika status pasif (yang sebelumnya hanya mengecek ketersediaan buffer Firebase) dengan validasi usia data real-time (`Math.abs(now - record.created_at) <= 15000`). Begitu ESP32 dicabut atau mati lebih dari 15 detik, status di pill header & floating HUD langsung otomatis berubah menjadi `OFFLINE` merah. *(Selesai - Commit 68312d9)*
- [x] **[TD-F18]** Mobile Optimization for ESI Chat Card & Quick Chips: Optimalisasi tampilan responsif khusus layar HP/mobile (< 992px) dengan memberikan dedicated viewport height pada panel chat ESI (clamp 400px - 520px) dan mengubah quick chips menjadi single-row horizontal scroll pada mobile, sementara tampilan pada layar laptop/desktop (>= 992px) dipertahankan 100% identik tanpa perubahan.
- [x] **[TD-F19]** Flutter Mobile UI Overhaul: Penyelarasan estetika visual Flutter Mobile agar 100% identik dengan Web Dashboard (Deep Midnight Navy #070D1E, Rich Slate Glass #0E172E, outline sky blue 22%, eliminasi progress bar tebal digantikan layout 2-baris tipografi bold 28pt & micro-labels pin/threshold, K3 emergency glass banner, grafik kurva Bezier spline halus dengan under-curve gradient, dan Zero-Warning Clean Code).
- [x] **[TD-F20]** Transisi Flutter Mobile ke Hybrid Bundled WebView Container (Opsi A): Memadukan secara utuh aset web lokal (`index.html`, `style.css`, `app.js`, `config.js`, `js/`, `assets/`) ke dalam package assets Flutter dengan `webview_flutter: ^4.13.1`, menghasilkan tampilan UI/UX mobile yang 100% identik secara sempurna dengan Web Dashboard (carousel slider, smooth scroll morphing, canvas sparkline real-time, Markdown ESI chat, dan glowing glass cards) sekaligus tetap mempertahankan kemampuan native Android (Splash screen, hardware Back button handling via `PopScope`, dan In-App OTA Update Engine `OtaUpdateService`).
- [x] **[TD-F21]** Full Dart Native 100% Web Parity & 120 FPS Rendering: Eliminasi total ketergantungan WebView yang berat dan lag. Rekonstruksi arsitektur antarmuka native secara presisi 100% identik dengan Web Dashboard: background atmosfer `assets/bg_campus.jpg` dengan gradien Midnight Navy, `CampusCarouselSlider` (3 foto kampus, swipe gestures, auto-slide 5s, dot indicators), `MiniSparklinePainter` (smooth Bezier spline real-time di setiap kartu sensor), `DashboardHeader`, dan `EsiFabButton` dengan rendering 60-120 FPS native Impeller/Skia, pemakaian memori hemat (~35 MB), dan nol lag.
- [x] **[TD-F22]** Pembersihan Dev Artifacts & Heartbeat Watchdog Offline Murni: Penghapusan tombol simulasi darurat (bolt) dan dialog pengaturan URL Firebase RTDB dari header mobile; penggantian dengan Node Selector pill (`NODE-MRS01 ▾`) yang memicu `NodeSelectorSheet`; pembaruan `TelemetryService` dengan Heartbeat Watchdog 15 detik yang mengeliminasi total generasi data acak palsu saat alat mati; sensor cards otomatis menampilkan badge `OFFLINE` dan grafik sparkline tetap tenang (flatline/freeze) tanpa gelombang palsu.
- [x] **[TD-F23]** Keyboard-Aware ESI Chat Modal & Native Markdown Renderer: Implementasi penyesuaian tinggi dinamis terhadap `viewInsets.bottom` keyboard pada `EsiChatBottomSheet` sehingga bilah input teks dan tombol kirim selalu melayang presisi di atas keyboard tanpa terpotong atau memicu overflow; pembuatan widget modular `EsiMessageBubble` (< 250 baris) dengan `flutter_markdown` (`MarkdownBody` + `MarkdownStyleSheet`) untuk me-render format cetak tebal, miring, inline code monospace, dan daftar berbutir ESI AI secara rapi tanpa tanda bintang mentah.
- [x] **[TD-F24]** Eliminasi Izin Sensitif `REQUEST_INSTALL_PACKAGES` & Solusi Hijau Play Protect: Penghapusan izin dropper `REQUEST_INSTALL_PACKAGES`, pustaka `open_filex`, dan `path_provider` dari aplikasi mobile; delegasi unduhan dan instalasi rilis baru ke browser sistem via `url_launcher` (`launchUrl(..., mode: LaunchMode.externalApplication)`); aplikasi ESS resmi terbebas 100% dari bendera peringatan berbahaya (*Harmful App*) Google Play Protect serta menghilangkan kendala HTTP 404 pada repositori private.
- [x] **[TD-F01]** Modularisasi `app.js` menjadi 5 komponen modular di `frontend/js/` (< 200 baris per file). *(Selesai)*

**4. Hardware Standardisasi & Optimasi Firmware v5.1 (Huda):**
- [x] **[TD-H01]** Standarisasi ambang batas K3 di satu sumber kebenaran (MQ-7: 50/150 PPM, MQ-2: 150/400 PPM di seluruh firmware C3).
- [x] **[TD-H02]** Standarisasi kurva ADC→PPM estimation dengan kalibrasi zero-baseline (MQ-7: 1550, MQ-2: 460).
- [x] **[TD-H03]** FreeRTOS Decoupled Cloud Task: Pisahkan transmisi HTTPS TLS Firebase ke background task via FreeRTOS Queue (`vFirebaseTask`, 8KB stack, priority 1) untuk zero main-loop latency.
- [x] **[TD-H04]** Kalibrasi Baseline Empiris Udara Bersih Laboratorium: Koreksi nilai idle baseline fisik menjadi MQ-7: 420 ADC (~0.34V) dan MQ-2: 360 ADC (~0.29V) menghilangkan zona mati (dead-zone) 1150 ADC.
- [x] **[TD-H05]** Sinkronisasi Cadence 1:1: Harmonisasi pembacaan sensor tiap 3 detik dengan push cloud tiap 3 detik via queue, menyamai responsivitas dan ketepatan tempo node ESP32-WROOM.
- [x] **[TD-H06]** Thermal Warmup Shield 45 Detik: Proteksi false alarm K3 DANGER dan raungan kipas 100% pada fase cold boot koil SnO2 dengan penahanan status WARMUP, indikator visual LED biru berkedip, dan hitung mundur OLED.
- [x] **[TD-H07]** 8x Hardware ADC Oversampling: Implementasi averaging 8 sampel ADC dengan jeda 50µs untuk meredam ripple switching daya dan fluktuasi derau analog.
- [x] Rancang dan uji prototipe breadboard ESP32-C3 SuperMini dengan OLED SSD1306, DHT22, MQ-7, MQ-2, dan LED RGB CC.
- [x] Integrasi driver kipas PWM transistor SS8050 dan pengujian 3-tahap (75%, 90%, 100%).
- [x] Streaming live telemetri edge-to-cloud ke Firebase RTDB buffer terverifikasi stabil (HTTP 200).
- [x] Uji empiris peredaman ripple filter input catu daya C1/C2 (5.10-5.15V menjadi 5.13-5.14V).
- [x] Dokumentasikan solusi USB flapping C3 via tombol BOOT+RST download mode.
- [x] Validasi respon fisik sensor gas (uji korek gas butana / asap) untuk membuktikan kenaikan ADC/PPM di atas baseline (Teruji fisik: MQ-7 188 ppm, MQ-2 504 ppm memicu K3:DANGER & Fan 100%).
- [x] Fabrikasi, perakitan, dan penyolderan papan PCB single-layer 70x40 mm (`PCB_ESS_5`) tuntas dan teruji fungsional 100%.
- [x] **[TD-H08]** Optimasi Tampilan OLED Statis Tunggal: Eliminasi rotasi halaman diagnostik RAW ADC; standardisasi tampilan menjadi 1 Dashboard Utama permanen (Suhu, RH, CO, Asap, Kipas PWM, Counter Paket `#sample`, dan Banner Status K3) dengan refresh rate non-blocking 1.000 ms.
- [x] **[TD-H09]** Hardening Reliabilitas I2C & OLED Edge Node: Implementasi I2C Bus Recovery (9 SCL clock pulses untuk clearing bus lockup saat reboot), inisialisasi OLED pertama kali pada rel 5V bersih sebelum beban motor/kipas, modulasi Self-Healing runtime tiap 5s (`recoverI2CBus()` + `tryInitOled()`), redesign POST senyap & kilat (~750ms: RGB sweep 450ms + fan blip 300ms @ 40%), dan pemendekan thermal warmup shield menjadi 15 detik (Commit e55f627).
- [x] **[TD-H10]** Streamline & Konsolidasi Arsitektur Firmware Edge: Penyatuan kode produksi menjadi single source of truth di `hardware/src/prodC3.cpp`, eliminasi folder redundan `hardware/prod/`, dan rekonfigurasi total `platformio.ini` dengan flash mode DIO, USB CDC on boot, dan upload speed 921600 (Teruji kompilasi PlatformIO sukses 100%).

**5. 🚀 DevOps & CI/CD Pipelines Mandiri (Huda):**
- [x] **[DEVOPS-01]** Setup GitHub Actions Workflow CI/CD Web ke Firebase Hosting (`.github/workflows/deploy-web.yml`) via Google ADC Service Account & multi-site `poltekom-ess`. *(Selesai - Commit 0190916)*
- [x] **[DEVOPS-02]** Setup 2-Stage CI/CD Backend (Cloud CI + Edge CD): GitHub Self-Hosted Runner resmi terpasang sebagai daemon systemd 24/7 di Raspberry Pi 3B (`actions.runner.*.service`) dengan label `pikos`, Stage 1 Cloud CI (Pytest & Flake8) + Stage 2 Edge CD (auto git pull, pip sync, passwordless systemctl restart ess-backend, dan automated healthcheck). *(Selesai & Operasional 100%)*
- [x] **[DEVOPS-03]** Implementasi Endpoint `GET /api/app/version` di FastAPI backend untuk version checking OTA mobile (`AppVersionResponse`, konfigurasi env settings, cleanup PEP 8 top-level imports, & unit test suite CI).
- [x] **[DEVOPS-04]** Implementasi In-App OTA Update Engine pada Flutter Mobile (`package_info_plus` + background download + Android PackageInstaller intent). *(Selesai - Model, Service, Dialog K3, & Auto-Check Terintegrasi)*
- [x] **[DEVOPS-05]** Setup GitHub Actions Release Workflow untuk kompilasi APK otomatis saat git tag rilis (`.github/workflows/release-mobile.yml`). *(Selesai - Cloud Build Ubuntu, Java 17, Flutter SDK Stable, Artifact Upload, & Auto-Publish GitHub Release)*
- [x] **[AI-06]** ESI Multi-Node Context-Aware & Offline Watchdog Upgrade: Injeksi `active_node_id` otomatis dari frontend dropdown ke `/api/chat`, Heartbeat Watchdog offline awareness (`is_online`, `age_seconds`) pada `get_telemetry`, tool `get_fleet_summary` (overview kesehatan seluruh armada sensor dalam 1 kali panggil), dan tool `get_devices` (metadata resmi armada dari Supabase).

---

# 🔒 Section 4: Pre-Public Release Security & Readiness Audit
> `[06-11-2026]` **6-Stage Pre-Public Repository Audit** — Persiapan sebelum repositori `syahrulhuda/EnvironmentalSensing` diubah dari **Private** menjadi **Public** pasca penyerahan ke dosen penguji — **Zaki**.

> [!NOTE]
> **STATUS KELAYAKAN PUBLIKASI: APPROVED & READY FOR PUBLIC RELEASE (DISETUJUI RESMI OLEH ZAKI - 10-NOV-2026)**  
> Seluruh 6 poin audit teknis & keamanan kritis (`PUB-01` s/d `PUB-06`) telah diselesaikan 100% dan lolos verifikasi empiris. Kunci Supabase lama telah dinonaktifkan di cloud (`HTTP 401`), Firebase RTDB telah terkunci (`auth != null`), fallback admin key telah dihapus, berkas CAD telah dirapikan, dan GitHub Ruleset proteksi branch `main` (`Block force pushes` & `Restrict deletions`) telah terpasang aktif. **Zaki telah menyelesaikan review menyeluruh dan secara resmi MENYETUJUI (APPROVED) perubahan visibilitas repositori menjadi PUBLIC**.

## 📊 Ringkasan Skor Audit Pra-Publikasi (6 Tahap)

| Tahap | Area Audit | Status | Ringkasan Temuan |
| :---: | :--- | :---: | :--- |
| **1** | **Riwayat Git (*Git History Deep Scan*)** | ✅ **RESOLVED** | Kunci Supabase lama telah dirotasi di cloud (`HTTP 401 UNAUTHORIZED_UNREGISTERED_API_KEY`), kunci baru aktif di Raspi (`HTTP 200`). |
| **2** | **File Aktif & Cloud Database** | ✅ **TERKUNCI & TERUJI** | Aturan `database.rules.json` terpasang `.write: "auth != null"`. Akses baca dashboard `HTTP 200 OK`, write liar `HTTP 401 Permission denied`. |
| **3** | **Keamanan Endpoint Backend & AI** | ✅ **TERLINDUNGI** | Fallback `ADMIN_API_KEY` dihapus total di `config.py`. Endpoint `POST /api/etl/trigger` menolak request tanpa key / key lama (`HTTP 401`). |
| **4** | **CI/CD & Raspi Self-Hosted Runner** | ✅ **AMAN** | Ketiga workflow (`deploy-backend`, `deploy-web`, `release-mobile`) hanya memicu pada `push` & `workflow_dispatch` (aman dari PR fork luar). |
| **5** | **Kebersihan Berkas (*Repo Hygiene*)** | ✅ **SELESAI** | Subfolder CAD duplikat dibersihkan; 14 berkas DXF kanonik Enclosure V2 terkonsolidasi rapi (Commit 0a6891c). |
| **6** | **Dokumentasi Akademik (Dosen)** | ✅ **SIAP (100%)** | `README.md`, `RULEBOOK.md`, dan `WHITEBOARD.md` sangat rapi, berbobot akademik, dan berstandar industri. |

---

## 🔍 Rincian Temuan Audit Pra-Publikasi (`PUB-01` s/d `PUB-06`)

1. **`[PUB-01]` 🚨 [CRITICAL] Supabase Secret Key (`sb_secret_...`) Bocor di Riwayat Commit Masa Lalu & Masih Aktif di Produksi**
   - **Lokasi Riwayat:** Commit `51183bb`, `bb5e8ac`, dan `367c216` (23–24 Sep 2026) pada berkas `backend/etl_worker.py`.
   - **Detail Temuan:** Meskipun sudah dihapus pada commit berikutnya, riwayat diff Git masih menyimpan string `SUPABASE_KEY` dengan awalan `sb_secret_hRgIlTrb..._uMB82nAW` untuk project `lrnmbhobpymxmzocrfto.supabase.co`. Hasil verifikasi *read-only* menunjukkan kunci tersebut **masih aktif (`HTTP 200 OK`)** di server Supabase produksi.
   - **Risiko:** Kunci `sb_secret_` memiliki hak akses *Service Role / Superuser* yang mem-bypass *Row Level Security (RLS)*. Jika repositori diubah menjadi Public tanpa rotasi kunci, bot pemindai GitHub akan mendeteksinya dalam hitungan detik dan dapat memanipulasi/menghapus seluruh tabel database.
   - **Mitigasi Wajib:**
     1. **Revoke / Roll Key** `sb_secret_...` tersebut di Dashboard Supabase dan perbarui `.env` di Raspberry Pi 3B dengan kunci baru.
     2. Bersihkan riwayat commit Git (`git filter-repo` / *orphan branch* bersih) sebelum repositori dibuka ke publik.

2. **`[PUB-02]` 🚨 [HIGH] Jejak SSID & Password Hotspot Kampus pada Riwayat Commit Lama**
   - **Lokasi Riwayat:** Commit `298d645` (`hardware/test/tes_wroom/tes_wroom.ino`) dan commit `b5099d0` / `c76c5ba` (`WHITEBOARD.md`).
   - **Detail Temuan:** Berkas aktif saat ini sudah menggunakan `#include "secrets.h"`, tetapi riwayat diff commit lama masih memuat teks SSID dan password Wi-Fi pengujian.
   - **Mitigasi Wajib:** Akan otomatis terhapus permanen bersamaan dengan pembersihan riwayat commit pada langkah mitigasi `[PUB-01]`.

3. **`[PUB-03]` ⚠️ [MEDIUM-HIGH] Default Fallback `ADMIN_API_KEY` Terbuka di `backend/app/core/config.py`**
   - **Lokasi:** `backend/app/core/config.py:62` (`ADMIN_API_KEY: str = os.getenv("ADMIN_API_KEY", "ess-secret-admin-key-2026")`).
   - **Risiko:** Jika variabel `ADMIN_API_KEY` pada `.env` server Raspberry Pi tidak disetel atau masih memakai nilai contoh bawaan, pihak luar yang membaca kode sumber publik dapat memicu endpoint `POST /api/etl/trigger` secara paksa.
   - **Mitigasi:** Ubah default fallback di `config.py` menjadi string kosong `""`, dan tolak request pada `/api/etl/trigger` apabila `settings.ADMIN_API_KEY` belum dikonfigurasi di `.env`.

4. **`[PUB-04]` ✅ [RESOLVED & EMPIRICALLY VERIFIED] Penguncian Aturan `.write` Firebase RTDB via Database Secret**
   - **Detail Temuan & Solusi:** Aturan Firebase Realtime Database pada path `telemetry/buffer` telah resmi dikunci menggunakan `".write": "auth != null"` dan `.read: true`.
   - **Bukti Uji Empiris (10-Nov-2026):**
     1. *Uji Tulis Tanpa Autentikasi (Penyerang Publik):*
        - `POST https://environmental-sensing-f6e1c-default-rtdb.asia-southeast1.firebasedatabase.app/telemetry/buffer.json`
        - Hasil: **`HTTP/1.1 401 Unauthorized`** (`{"error": "Permission denied"}`). Akses tulis liar berhasil dicegah 100%.
     2. *Uji Baca Dashboard Publik:*
        - `GET .../telemetry/buffer.json?shallow=true`
        - Hasil: **`HTTP/1.1 200 OK`**. Web Dashboard (`poltekom-ess.web.app`) tetap membaca streaming grafik telemetri tanpa hambatan.
     3. *Uji Tulis Terautentikasi (ESP32 via `?auth=`):*
        - `POST .../telemetry/buffer.json?auth=<DATABASE_SECRET>`
        - Hasil: **`HTTP/1.1 200 OK`** (Paket record berhasil dibuat).
     4. *Uji Hapus Terautentikasi (ETL Worker Pruning):*
        - `DELETE .../telemetry/buffer/<test_id>.json?auth=<DATABASE_SECRET>`
        - Hasil: **`HTTP/1.1 200 OK`** (`null`). Raspberry Pi ETL worker dapat memangkas buffer sliding window 2 jam tanpa kendala izin.

5. **`[PUB-05]` 🟡 [LOW-MEDIUM] Duplikasi 3 Subfolder CAD/DXF di Dalam `schematics/`**
   - **Detail Temuan:** Folder `schematics/` saat ini memuat 3 subfolder yang sebagian isinya berulang (`schematics/dxf/`, `schematics/dxf_v2/`, dan `schematics/dxf_desain_3d_enclosure_v2/`).
   - **Mitigasi:** Merapikan struktur folder `schematics/` agar hanya menyisakan berkas gambar kerja kanonik tanpa duplikasi sebelum dinilai oleh dosen (Selesai - Commit 0a6891c).

6. **`[PUB-06]` ✅ [RESOLVED & ENFORCED] Evaluasi Keamanan CI/CD, Runner, & Branch Protection Ruleset**
   - **Hasil Verifikasi CI/CD & Runner:**
     - `GEMINI_API_KEY` **100% aman** (tidak pernah ter-commit sepanjang sejarah repositori).
     - Endpoint `/api/chat` terlindungi oleh `InMemoryRateLimiter` (15 request/menit/IP).
     - Seluruh workflow GitHub Actions (`deploy-backend.yml`, `deploy-web.yml`, `release-mobile.yml`) hanya menggunakan trigger `on: push` dan `workflow_dispatch` (aman dari PR fork luar).
   - **Status GitHub Ruleset `production` (Aktif Terverifikasi 10-Nov-2026):**
     - Target Branch: `main` (Default branch).
     - Enforcement Status: **`Active`** (3 branch rules aktif).
     - Aturan 1: **`Restrict deletions`** (Mencegah penghapusan branch `main`).
     - Aturan 2: **`Block force pushes`** (Mencegah penimpaan riwayat commit historis portofolio).
     - Aturan 3: **`Require a pull request before merging`** (Wajib Pull Request untuk kontributor baru POLTEKOM, dengan `Dismiss stale reviews`, `Require conversation resolution`, dan fleksibilitas metode merge `Merge, Squash, Rebase`).
     - Bypass List: **`Repository admin`** (`syahrulhuda` - *Always allow*) untuk pemeliharaan langsung dan keadaan darurat.

---

### 🛡️ Checklist Persiapan Sebelum Klik "Make Public" (Zaki & Huda)
- [x] **[PUB-01]** Rotasi/Revoke `sb_secret_...` lama di Dashboard Supabase dan pasang key baru di `.env` Raspberry Pi 3B (Selesai - Kunci lama terbukti mati HTTP 401 & endpoint /api/devices sukses HTTP 200).
- [x] **[PUB-02]** Keputusan Git History: Kunci Supabase lama dirotasi/dimatikan di cloud (aman 100%), history commit dipertahankan untuk penilaian portofolio akademik.
- [x] **[PUB-03]** Hapus nilai default fallback `ADMIN_API_KEY` di `backend/app/core/config.py` dan validasi otentikasi di `routes.py` (Selesai - Commit 903a553, request tanpa key / key lama terbukti ditolak HTTP 401).
- [x] **[PUB-04]** Kunci aturan `.write` pada Firebase RTDB Console (`auth != null`) sambil mempertahankan akses baca dashboard (Selesai - Teruji HTTP 401 write unauthorized, HTTP 200 read dashboard, HTTP 200 authenticated write/delete).
- [x] **[PUB-05]** Bersihkan duplikasi subfolder DXF/STL di dalam `schematics/` (Selesai - Konsolidasi Part 1-14 Enclosure V2 - Commit 0a6891c).
- [x] **[PUB-06]** Setup & Aktivasi GitHub Ruleset 'production' pada branch `main` (`Restrict deletions`, `Block force pushes`, dan `Require PR` dengan bypass Admin). *(Selesai, Aktif, & APPROVED oleh Zaki per 10-Nov-2026)*.
- [x] **[PUB-07]** Pemangkasan Rilis Mobile Lama & Public Release Launch: Rilis lama dipangkas, repositori `syahrulhuda/EnvironmentalSensing` resmi diubah menjadi **PUBLIC** (Status: LIVE & Verified via HTTP 200).

### 📝 Catatan Pengesahan Persetujuan Publikasi (Zaki & AI Pair - 10 November 2026):
1. **Verifikasi Keamanan:** Supabase key lama terbukti mati (`HTTP 401`), Firebase RTDB terbukti menolak penulisan tanpa token (`HTTP 401`), endpoint ETL admin terkunci, dan Raspberry Pi Self-Hosted Runner terisolasi total dari PR luar.
2. **Kesiapan Akademik:** Monorepo bersih, arsitektur 5-layer tervalidasi, firmware single-source `prodC3.cpp` operasional 100%, serta dokumentasi lengkap.
3. **Keputusan Akhir:** **APPROVED & RESMI DIPUBLIKASIKAN (LIVE PUBLIC REPOSITORY).**
