syahrulhuda/EnvironmentalSensing/schematics/arsitektur_stack_tunnel_dan_case.png

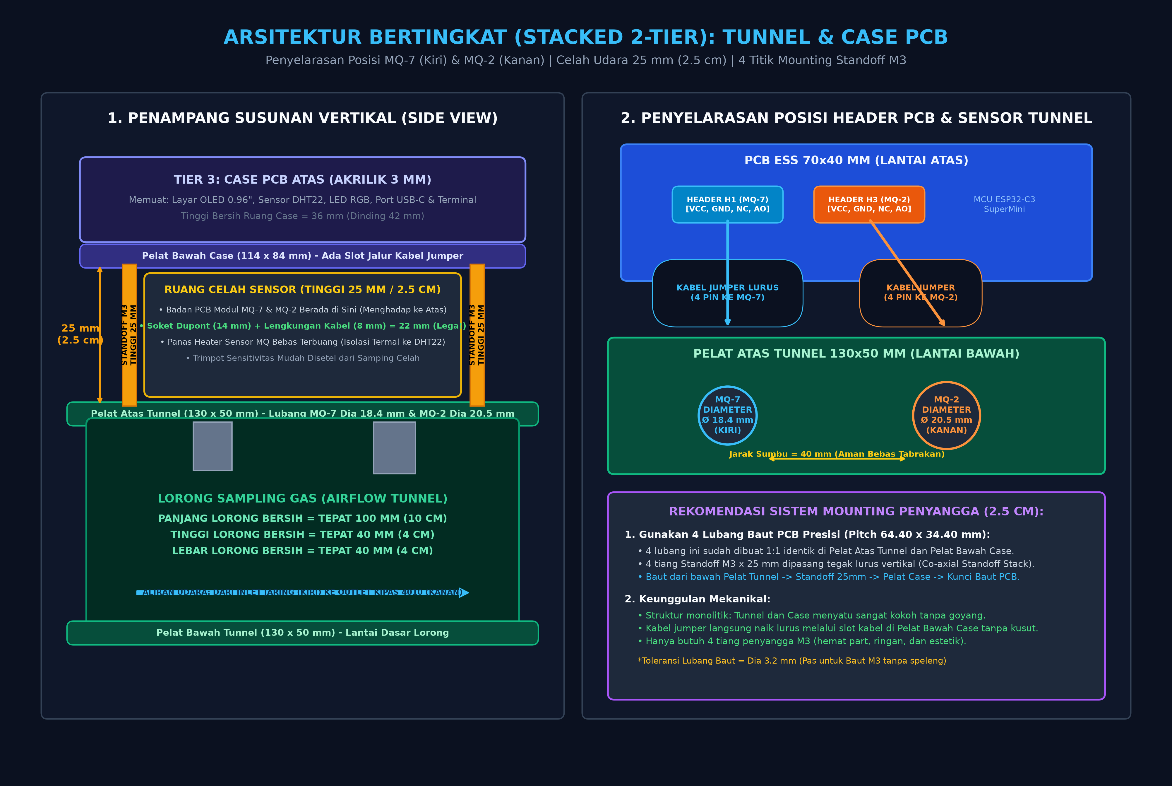
schematics/arsitektur_stack_tunnel_dan_case.png
