syahrulhuda/EnvironmentalSensing/schematics/panduan_pinout_pcb_ess.png

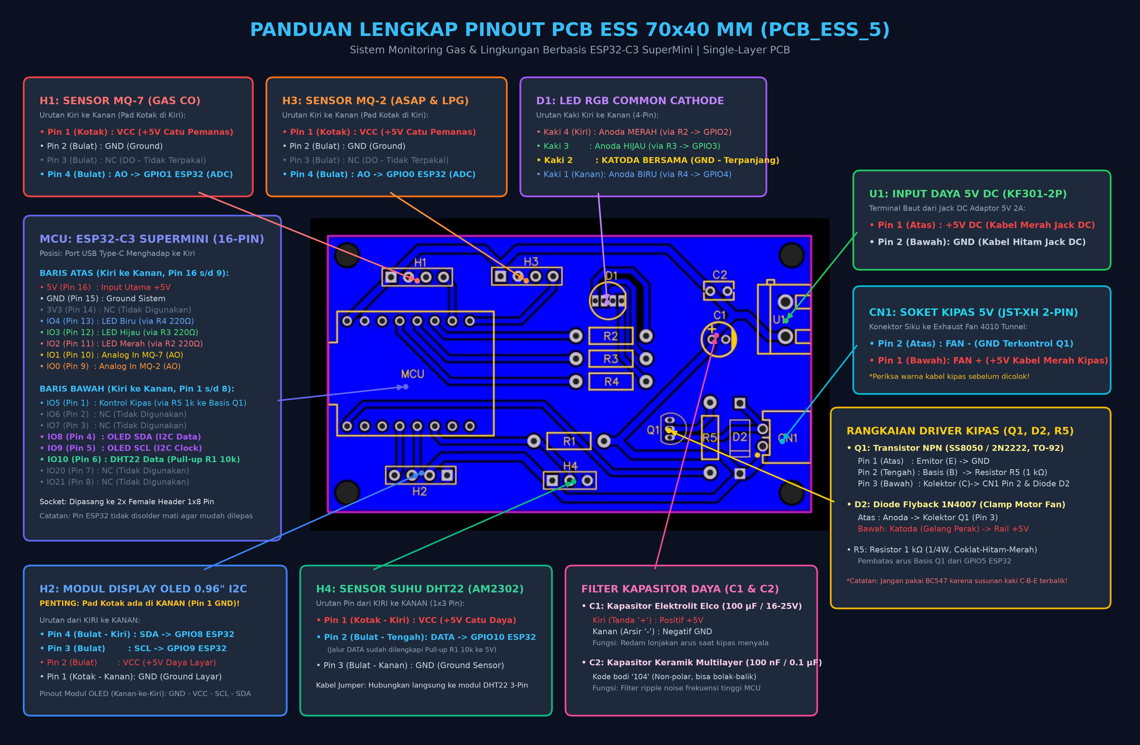
schematics/panduan_pinout_pcb_ess.png
