syahrulhuda/EnvironmentalSensing/schematics/preview_laser_cutting_v2.png

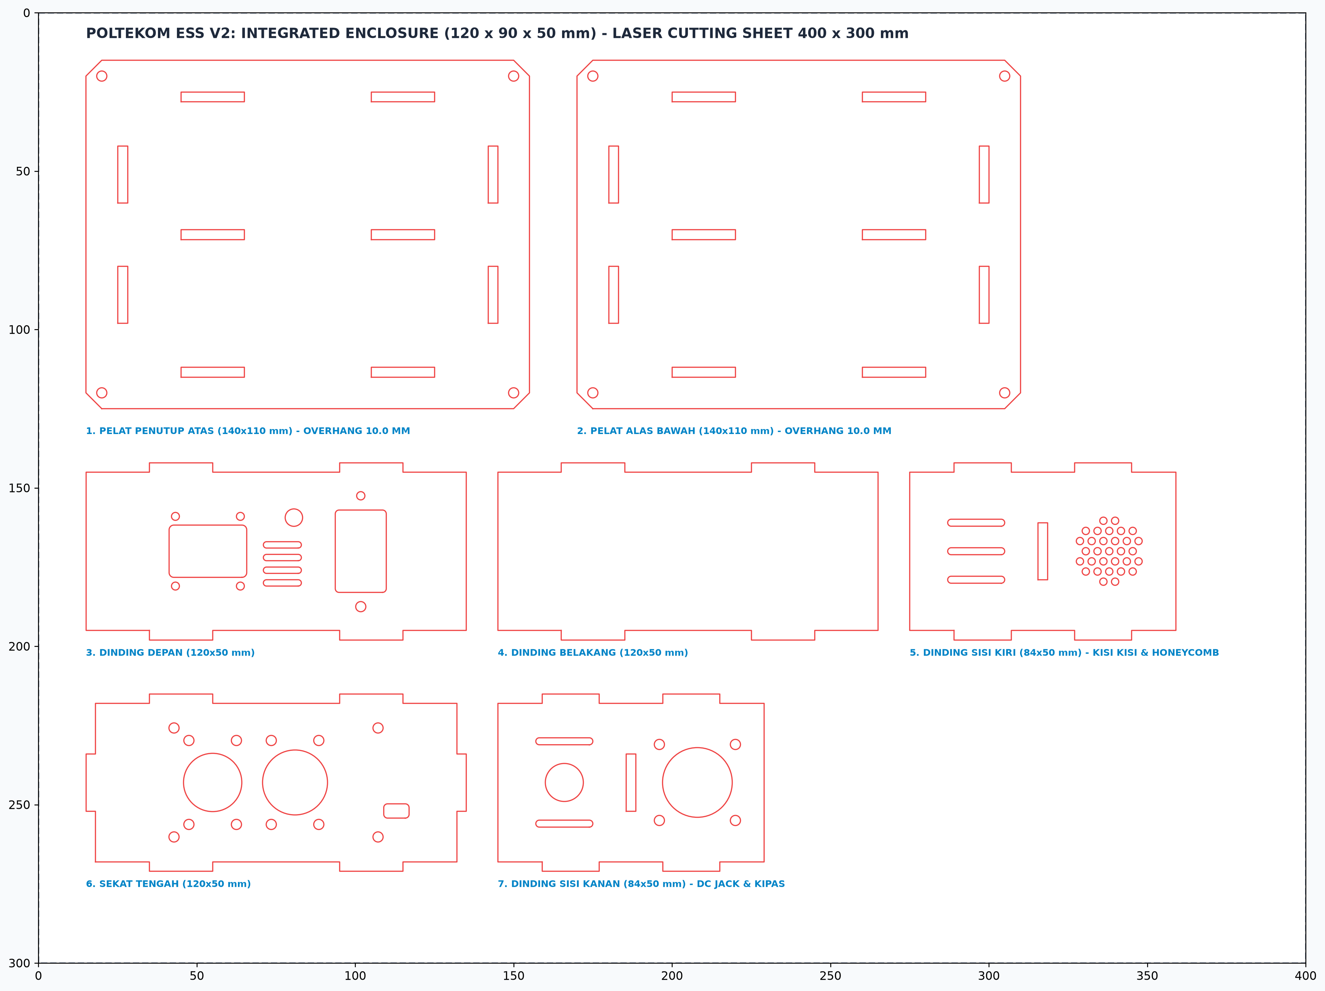
schematics/preview_laser_cutting_v2.png
