syahrulhuda/EnvironmentalSensing/schematics/dxf/case_dinding_belakang.dxf

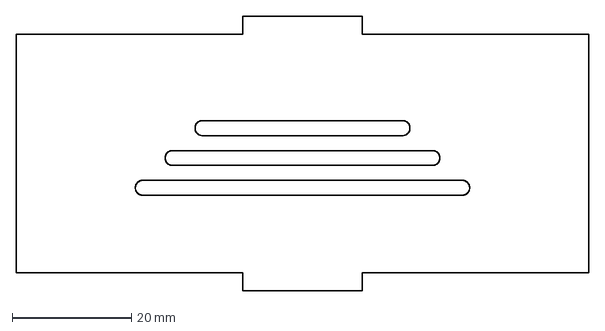
[picture p14: CAD file, 2026-11-04]
schematics/dxf/case_dinding_belakang.dxf
96.0 x 46.0 mm
