syahrulhuda/EnvironmentalSensing/schematics/dxf_desain_3d_enclosure_v2/14_pcb_ess_5.stl

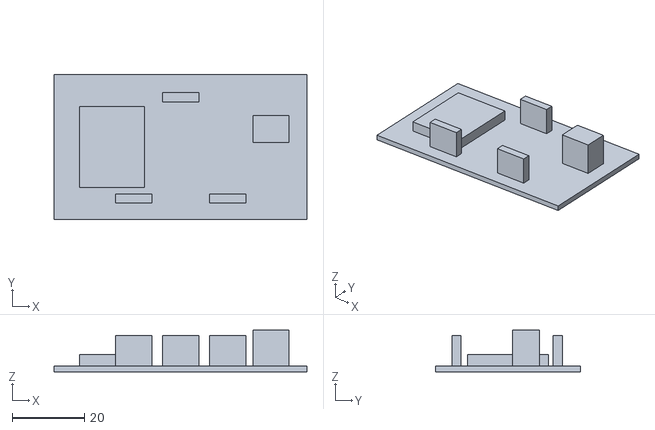
[picture p15: CAD file, 2026-11-04]
schematics/dxf_desain_3d_enclosure_v2/14_pcb_ess_5.stl
70.0 x 40.0 x 11.6
