syahrulhuda/EnvironmentalSensing/schematics/laser_cutting_v2_integrated_box.dxf

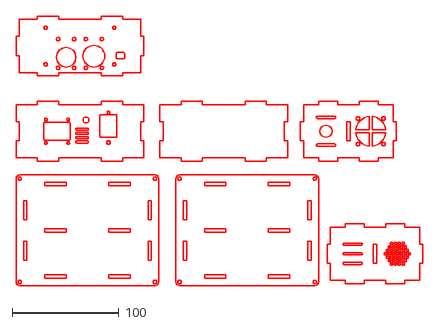
[picture p16: CAD file, 2026-11-04]
schematics/laser_cutting_v2_integrated_box.dxf
382.0 x 253.0
