syahrulhuda/EnvironmentalSensing/schematics/dxf/tunnel_outlet_fan.dxf

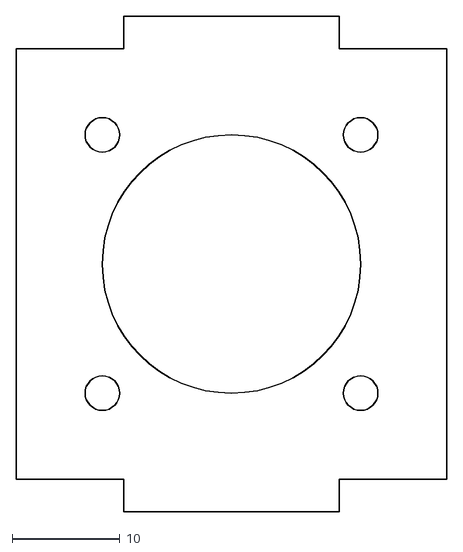
[picture p17: CAD file, 2026-11-04]
schematics/dxf/tunnel_outlet_fan.dxf
40.0 x 46.0
