syahrulhuda/EnvironmentalSensing/schematics/dxf_desain_3d_enclosure_v2/8_spacer_nylon_male_female_m3_50mm.stl

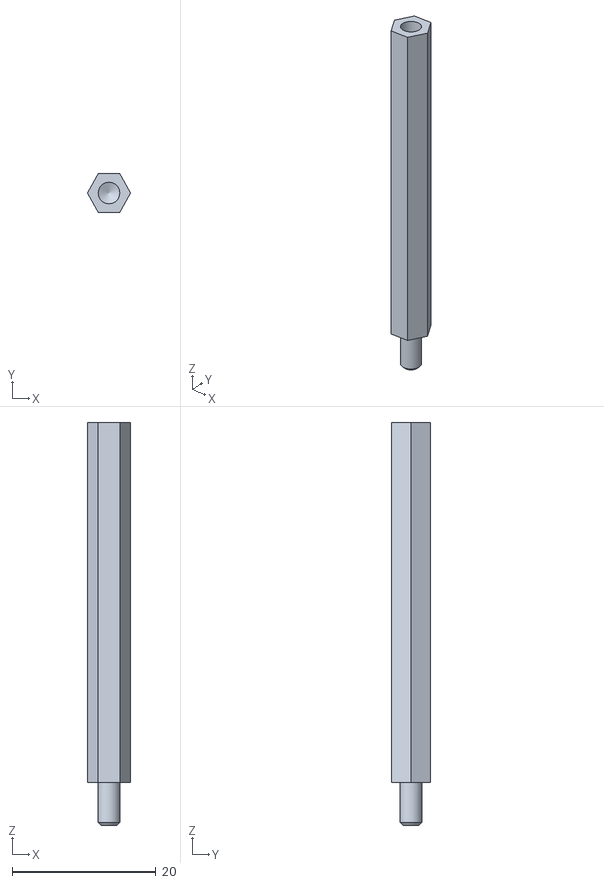
[picture p18: CAD file, 2026-11-04]
schematics/dxf_desain_3d_enclosure_v2/8_spacer_nylon_male_female_m3_50mm.stl
6.00 x 5.40 x 56.0
