syahrulhuda/EnvironmentalSensing/schematics/dxf/tunnel_inlet_depan.dxf

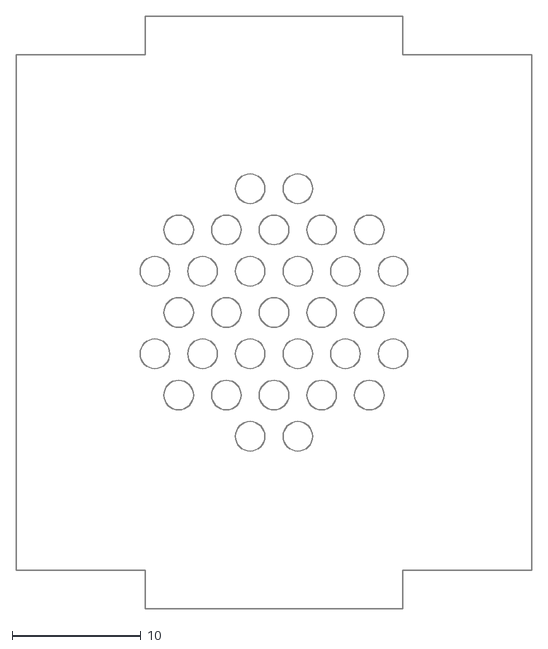
[picture p19: CAD file, 2026-11-04]
schematics/dxf/tunnel_inlet_depan.dxf
40.0 x 46.0
