syahrulhuda/EnvironmentalSensing/schematics/dxf_desain_3d_enclosure_v2/12_modul_sensor_mq2.stl

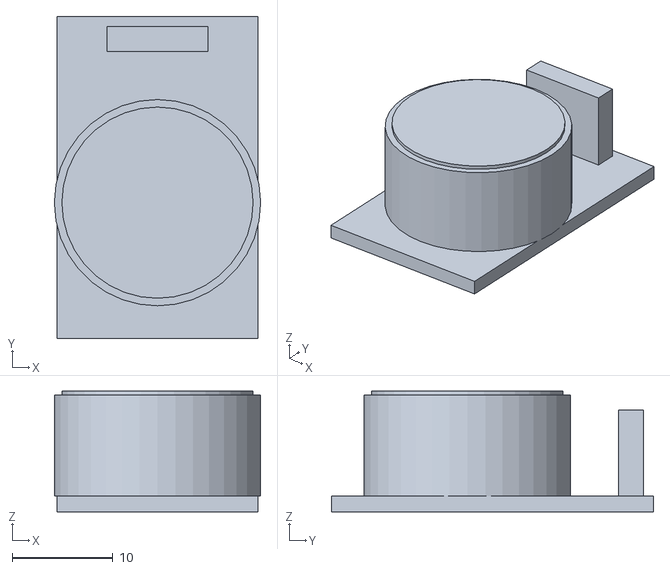
[picture p20: CAD file, 2026-11-04]
schematics/dxf_desain_3d_enclosure_v2/12_modul_sensor_mq2.stl
20.5 x 32.0 x 12.0
