syahrulhuda/EnvironmentalSensing/schematics/dxf/tunnel_pelat_atas.dxf

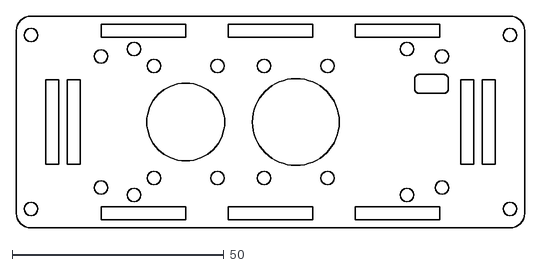
[picture p21: CAD file, 2026-11-04]
schematics/dxf/tunnel_pelat_atas.dxf
120.0 x 50.0
