syahrulhuda/EnvironmentalSensing/schematics/dxf_desain_3d_enclosure_v2/8_spacer_nylon_hex_m3_50mm.dxf

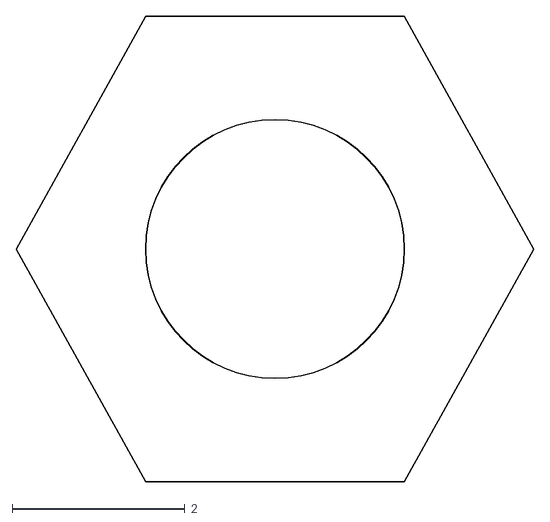
[picture p22: CAD file, 2026-11-04]
schematics/dxf_desain_3d_enclosure_v2/8_spacer_nylon_hex_m3_50mm.dxf
6.00 x 5.40
