syahrulhuda/EnvironmentalSensing/schematics/dxf/case_pelat_atas.dxf

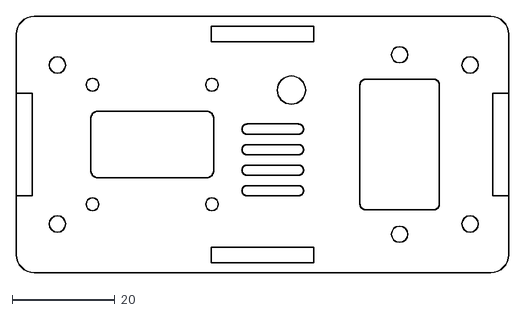
[picture p23: CAD file, 2026-11-04]
schematics/dxf/case_pelat_atas.dxf
96.0 x 50.0
