syahrulhuda/EnvironmentalSensing/schematics/dxf_desain_3d_enclosure_v2/3_dinding_depan.dxf

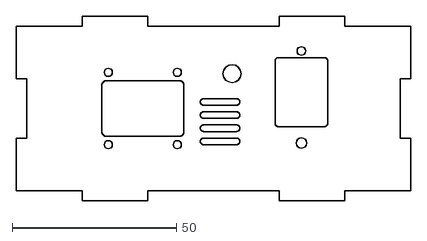
[picture p24: CAD file, 2026-11-04]
schematics/dxf_desain_3d_enclosure_v2/3_dinding_depan.dxf
120.0 x 56.0
