syahrulhuda/EnvironmentalSensing/schematics/dxf/case_dinding_kanan_power.dxf

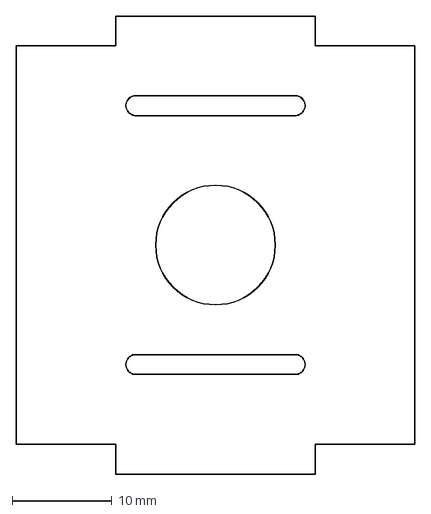
[picture p25: CAD file, 2026-11-04]
schematics/dxf/case_dinding_kanan_power.dxf
40.0 x 46.0 mm
