syahrulhuda/EnvironmentalSensing/schematics/dxf_desain_3d_enclosure_v2/1_pelat_penutup_atas.dxf

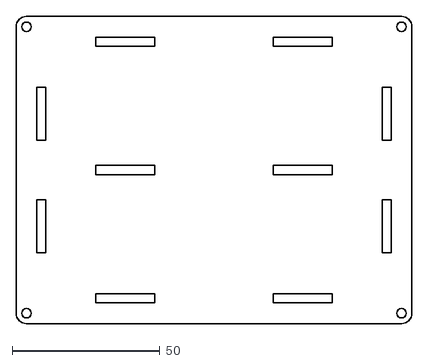
[picture p26: CAD file, 2026-11-04]
schematics/dxf_desain_3d_enclosure_v2/1_pelat_penutup_atas.dxf
134.0 x 104.0
