syahrulhuda/EnvironmentalSensing/schematics/dxf/tunnel_pelat_bawah.dxf

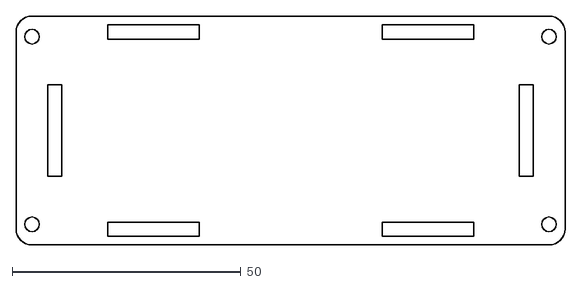
[picture p27: CAD file, 2026-11-04]
schematics/dxf/tunnel_pelat_bawah.dxf
120.0 x 50.0
