syahrulhuda/EnvironmentalSensing/schematics/dxf_desain_3d_enclosure_v2/7_dinding_sisi_kanan.dxf

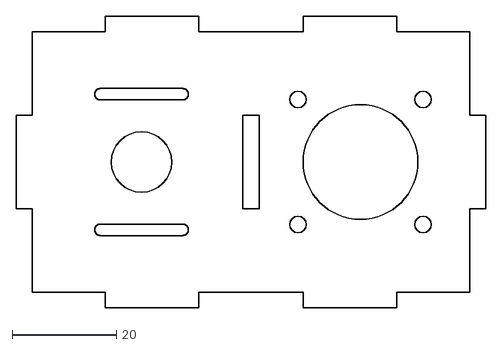
[picture p28: CAD file, 2026-11-04]
schematics/dxf_desain_3d_enclosure_v2/7_dinding_sisi_kanan.dxf
90.0 x 56.0
