syahrulhuda/EnvironmentalSensing/schematics/dxf/tunnel_dinding_samping.dxf

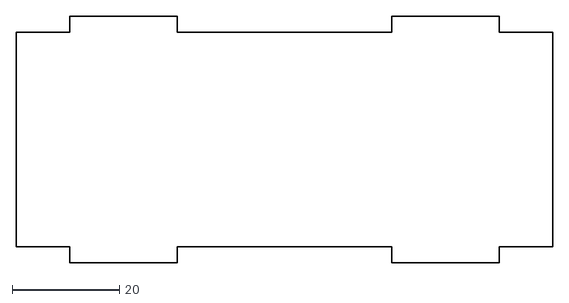
[picture p29: CAD file, 2026-11-04]
schematics/dxf/tunnel_dinding_samping.dxf
100.0 x 46.0
