syahrulhuda/EnvironmentalSensing/schematics/dxf_desain_3d_enclosure_v2/4_sekat_tengah.dxf

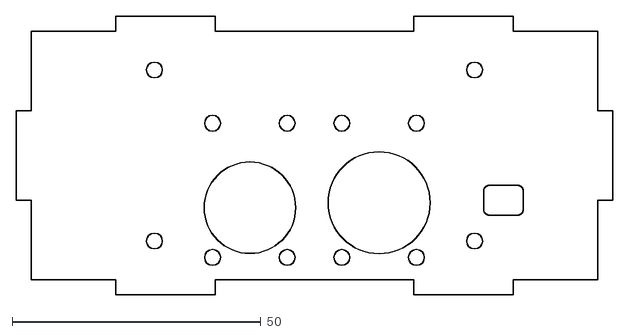
[picture p30: CAD file, 2026-11-04]
schematics/dxf_desain_3d_enclosure_v2/4_sekat_tengah.dxf
120.0 x 56.0
