syahrulhuda/EnvironmentalSensing/schematics/dxf/case_dinding_depan.dxf

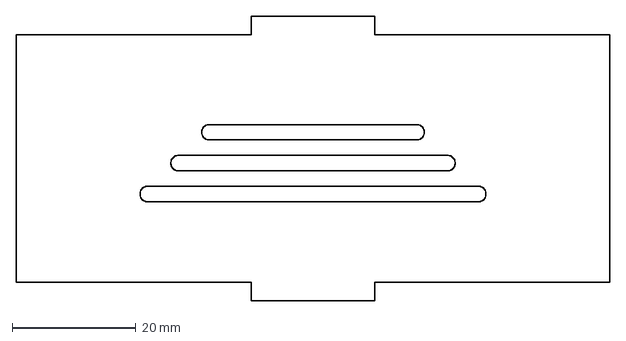
[picture p31: CAD file, 2026-11-04]
schematics/dxf/case_dinding_depan.dxf
96.0 x 46.0 mm
