syahrulhuda/EnvironmentalSensing/schematics/dxf_desain_3d_enclosure_v2/11_mur_hex_m3.stl

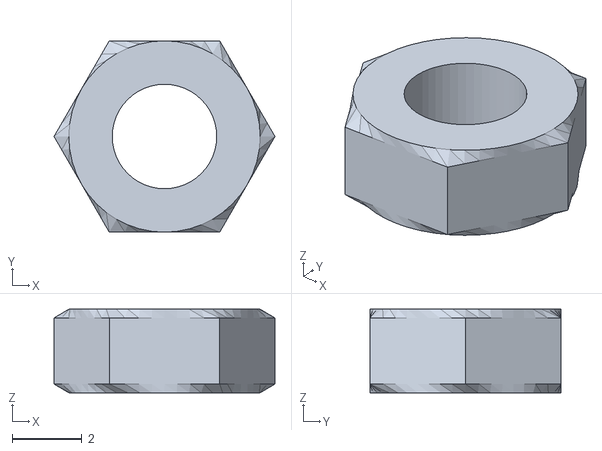
[picture p32: CAD file, 2026-11-04]
schematics/dxf_desain_3d_enclosure_v2/11_mur_hex_m3.stl
6.35 x 5.50 x 2.40
