syahrulhuda/EnvironmentalSensing/schematics/dxf/case_dinding_kiri_usbc.dxf

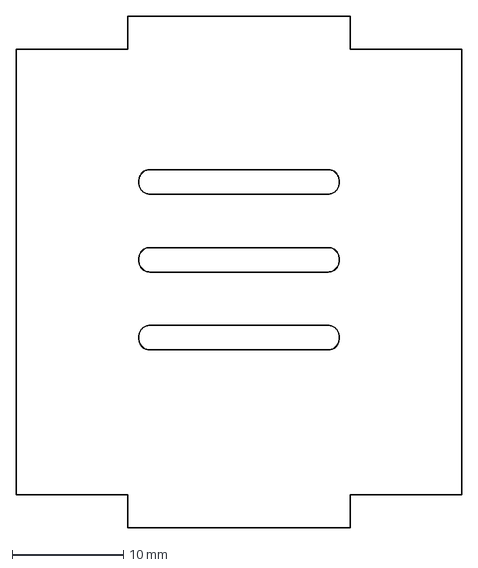
[picture p33: CAD file, 2026-11-04]
schematics/dxf/case_dinding_kiri_usbc.dxf
40.0 x 46.0 mm
