syahrulhuda/EnvironmentalSensing/schematics/dxf_desain_3d_enclosure_v2/10_baut_dan_mur_m3_10mm.stl

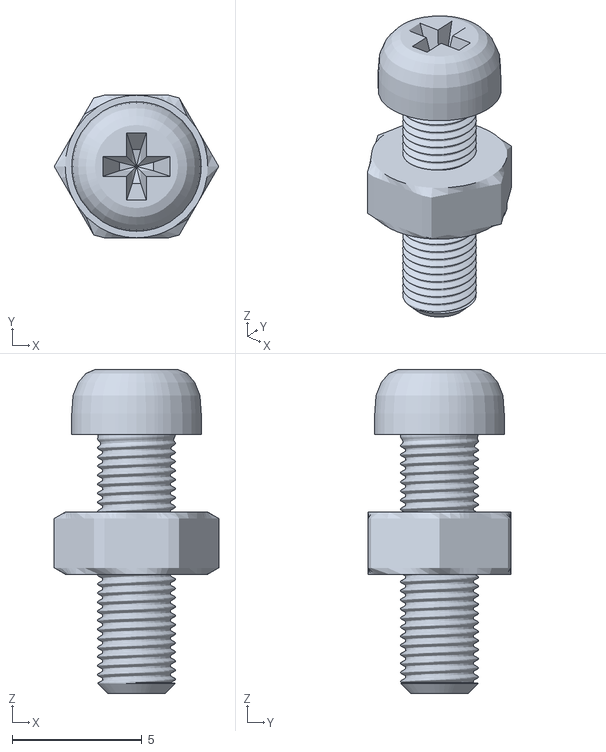
[picture p34: CAD file, 2026-11-04]
schematics/dxf_desain_3d_enclosure_v2/10_baut_dan_mur_m3_10mm.stl
6.35 x 5.50 x 12.5
