syahrulhuda/EnvironmentalSensing/schematics/dxf_desain_3d_enclosure_v2/9_baut_pan_head_m3_10mm.stl

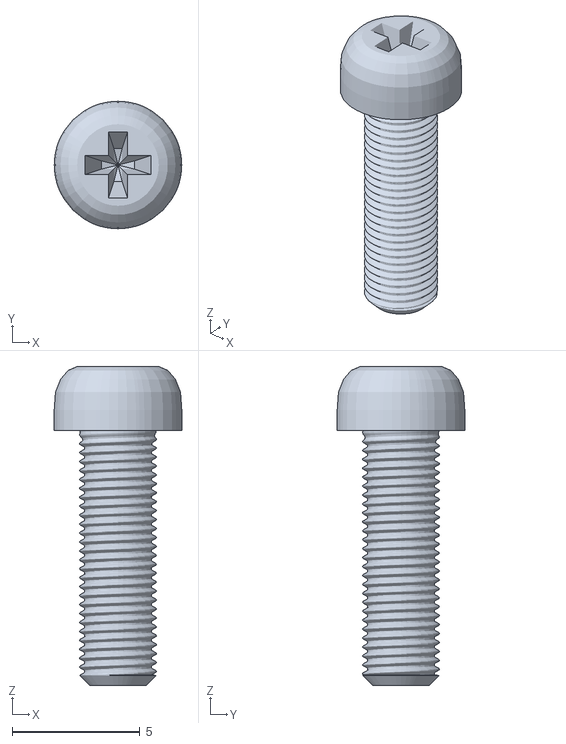
[picture p35: CAD file, 2026-11-04]
schematics/dxf_desain_3d_enclosure_v2/9_baut_pan_head_m3_10mm.stl
5.00 x 5.00 x 12.5
