syahrulhuda/EnvironmentalSensing/schematics/dxf_desain_3d_enclosure_v2/2_pelat_dasar_bawah.dxf

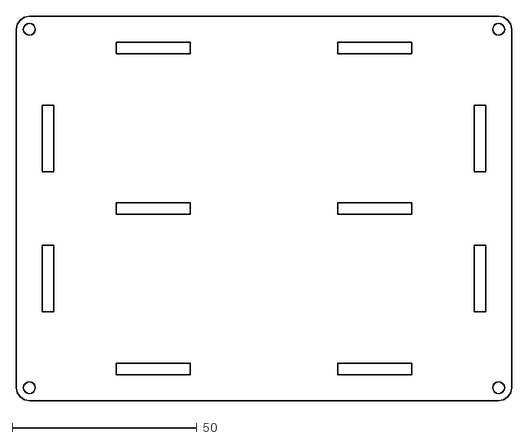
[picture p36: CAD file, 2026-11-04]
schematics/dxf_desain_3d_enclosure_v2/2_pelat_dasar_bawah.dxf
134.0 x 104.0
