syahrulhuda/EnvironmentalSensing/schematics/dxf_desain_3d_enclosure_v2/5_dinding_belakang.dxf

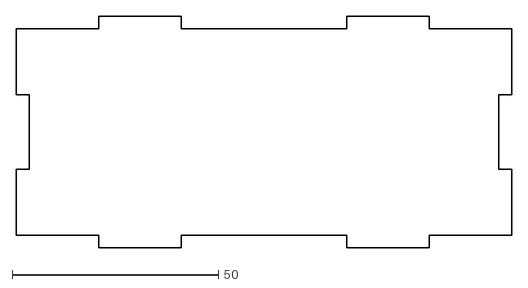
[picture p37: CAD file, 2026-11-04]
schematics/dxf_desain_3d_enclosure_v2/5_dinding_belakang.dxf
120.0 x 56.0
