syahrulhuda/EnvironmentalSensing/schematics/dxf_desain_3d_enclosure_v2/6_dinding_sisi_kiri.dxf

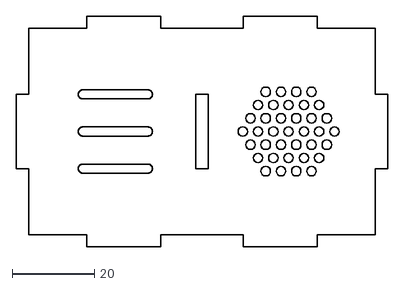
[picture p38: CAD file, 2026-11-04]
schematics/dxf_desain_3d_enclosure_v2/6_dinding_sisi_kiri.dxf
90.0 x 56.0
