syahrulhuda/EnvironmentalSensing/schematics/dxf_desain_3d_enclosure_v2/13_modul_sensor_mq7.stl

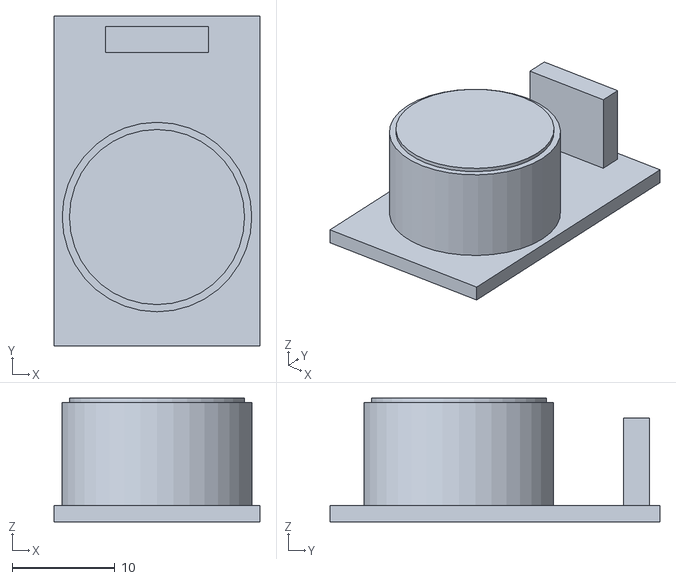
[picture p39: CAD file, 2026-11-04]
schematics/dxf_desain_3d_enclosure_v2/13_modul_sensor_mq7.stl
20.0 x 32.0 x 12.0
