syahrulhuda/EnvironmentalSensing/(list of files, cad)

Other CAD files:
schematics/dxf_desain_3d_enclosure_v2/10_baut_dan_mur_m3_10mm.dxf
schematics/dxf_desain_3d_enclosure_v2/8_spacer_nylon_male_female_m3_50mm.dxf
schematics/dxf_desain_3d_enclosure_v2/9_baut_pan_head_m3_10mm.dxf
