syahrulhuda/EnvironmentalSensing/(list of files, drawings)

Other design files:
schematics/PCB_PCB_ESS_5_2026-10-09.json
schematics/SCH_ESS_2026-10-08.json
