syahrulhuda/EnvironmentalSensing/hardware/prodC3/secrets.example.h

// =============================================================================
// TEMPLATE KREDENSIAL RAHASIA HARDWARE (PUBLIC TEMPLATE)
// Salin file ini menjadi "secrets.h" di folder yang sama dan isi nilai aslinya.
// File "secrets.h" otomatis di-ignore oleh Git (Pilar 5: Zero Hardcoding).
// =============================================================================

#pragma once

// Kredensial Jaringan Wi-Fi Bengkel
#define SECRET_WIFI_SSID    "NAMA_WIFI_ATAU_HOTSPOT_ANDA"
#define SECRET_WIFI_PASS    "PASSWORD_WIFI_ANDA"

// Kunci Otentikasi / Provisioning Perangkat
#define WORKSHOP_PROV_KEY   "POLTEKOM-K3-PROV-TOKEN-2026"
