syahrulhuda/EnvironmentalSensing/(commit log)

2026-09-24 docs: add secrets.example.h, update .gitignore and log device claiming roadmap in WHITEBOARD
2026-09-24 fix(ai): enhance tool resilience with device_id alias normalization and automatic NODE-MRS01 fallback
2026-09-24 feat(ai): add real-time clock context and hour_wib temporal filtering to ESI agent
2026-09-24 refactor(backend): clean modular architecture, ESS/ESI rebranding, and Raspberry Pi 3B deployment setup
2026-09-24 docs: archive Raspberry Pi 3B deployment blueprint to WHITEBOARD.md and cleanup README_RASPI
2026-09-28 feat(hardware): tambahkan pembacaan sensor gas dan asap mq2 pada pin d35
2026-09-28 feat(backend): integrasi penuh telemetri etl dan penalaran ai untuk sensor mq2
2026-09-30 docs(whiteboard): deep audit codebase — the good, the bad, the ugly (29 temuan)
2026-10-08 docs(hardware): add hardware bill of materials and schematics for ESS node v5
    [PCB_PCB_ESS_5_2026-10-08.json, SCH_ESS_2026-10-08.json]
2026-10-08 refactor(pcb): update refined trace routing and bounding box in PCB_ESS_5
    [PCB_PCB_ESS_5_2026-10-08.json]
2026-10-08 docs(schematics): update EasyEDA exports, add PCB SVG render, and correct DHT22 pin mapping in BOM
    [PCB_PCB_ESS_5_2026-10-08.json, SCH_ESS_2026-10-08.json]
2026-10-09 docs(schematics): add 2D laser-cut acrylic designs for PCB case and sensor tunnel
2026-10-09 feat(hardware): migrate firmware to ESP32-C3, add SSD1306 OLED, gas calibration, and offline test bench
    - Replace LiquidCrystal_I2C with Adafruit SSD1306 and GFX library
    - Implement offline test bench sketch (tes_c3.ino) with I2C timeout protection
    - Standardize K3 thresholds and add clean air baseline calibration (MQ-7: 1550, MQ-2: 460)
    - Add thermal cross-heating compensation offset (TEMP_OFFSET) for DHT22
    [tes_c3.ino]
2026-10-09 docs(schematics): update BOM with breadboard test status and refresh PCB layout export
    - Update COMPONENTS.md status to physical verified for ESP32-C3, OLED, MQ sensors, RGB LED, and C1/C2 filter
    - Add multimeter empirical proof notes (ripple smoothed from 5.10-5.15V to 5.13-5.14V)
    - Document USB flapping resolution and DHT22 thermal clearance guidelines
    - Refresh EasyEDA PCB layout export to 2026-10-09 revision
    [PCB_PCB_ESS_5_2026-10-08.json, PCB_PCB_ESS_5_2026-10-09.json]
2026-10-09 docs(project): update WHITEBOARD grand plan and README with C3 quickstart
    - Mark breadboard prototype and filter C1/C2 validation as 100% complete in WHITEBOARD
    - Resolve TD-H01 (K3 thresholds) and TD-H02 (PPM curves) in WHITEBOARD audit
    - Update README Layer 1 architecture with ESP32-C3 SuperMini and OLED SSD1306
    - Add Arduino IDE flashing guide with DIO flash mode, USB CDC enabled, and bootloader recovery combo
2026-10-15 feat(hardware): add ESP32-C3 production firmware and reorganize test suites
    - Add prodC3.ino production firmware with legacy WPA2 CCMP emulation and anti-sag power tuning
    - Integrate PWM fan speed governor (SS8050 NPN driver) coupled with K3 hazard evaluation
    - Reorganize test bench sketches into hardware/test/
    - Provide secrets.example.h templates honoring zero-hardcoding security policy
    - Synchronize hardware/src/main.cpp
    [prodC3.ino, secrets.example.h, tes_c3.ino, tes_wroom.ino]
2026-10-19 fix(hardware): remove hardcoded Wi-Fi credentials in test sketch (SEC-01)
    - Isolate Wi-Fi credentials in tes_wroom.ino using secrets.h fallback
    - Replace plaintext SSID and password with secure preprocessor macro checks
    - Adheres to Pillar 5 (Zero Hardcoded Secrets)
    [tes_wroom.ino]
2026-10-19 fix(backend): guarantee chronological ordering for latest telemetry (REL-02)
    - Replace dict order assumption with max(created_at) timestamp evaluation
    - Safely filter dictionary candidates and guard against empty buffers
    - Resolves REL-02
2026-10-20 fix(frontend): align DHT22 sensor pin label with physical ESP32-C3 hardware (TD-F08)
2026-10-27 feat(web): streamline compact sensor cards, add live telemetry canvas, and fix scroll flow
2026-10-27 feat(web): implement 3-color minimalist palette, remove header simulation button, and transform hero cards to individual sparkline cards
2026-10-28 feat(backend): add GET /api/devices endpoint to query registered nodes from Supabase PostgreSQL
2026-10-29 fix(security): resolve SEC-02 and TD-B03 with fail-fast config and rtdb rules
    [secrets.example.h, tes_wroom.ino]
2026-10-30 feat(hardware): upgrade C3 firmware to v5.1 with FreeRTOS decoupled cloud task, empirical calibration, and warmup shield
2026-10-30 feat(frontend): implement smart compact header, dynamic chat card height, and 3-button POLTEKOM footer
2026-10-30 fix(frontend): deterministic header hide, dynamic ESI card resize clamped above footer, and cache-busting v5.3
2026-10-30 feat(ci): implement 2-Stage Backend CI/CD pipeline and pytest test suite (DEVOPS-02)
2026-10-30 docs: record DEVOPS-02 100% operational with systemd self-hosted runner on Raspberry Pi 3B
2026-10-30 fix(hardware): stabilize OLED I2C at 100kHz, decouple render schedule, and add register reset commands
    [prodC3.ino]
2026-11-02 fix(hardware): implement true I2C hardware ping for OLED presence detection and headless fallback
    [prodC3.ino]
2026-11-02 feat(hardware): optimize OLED display to single static dashboard without page switching
2026-11-02 feat(hardware): remove fan percentage from OLED dashboard
2026-11-04 feat(frontend): optimize mobile layout for ESI chat and sync enclosure schematics (TD-F18)
    [10_baut_dan_mur_m3_10mm.dxf, 10_baut_dan_mur_m3_10mm.stl, 11_mur_hex_m3.stl, 12_modul_sensor_mq2.stl, 13_modul_sensor_mq7.stl, 14_pcb_ess_5.stl, 1_pelat_penutup_atas.dxf, 2_pelat_dasar_bawah.dxf]
2026-11-06 docs(audit): record 6-stage pre-public release security and readiness audit in WHITEBOARD
2026-11-09 refactor(schematics): remove duplicate DXF folders and consolidate canonical 3D enclosure V2 parts (PUB-05)
    [baut_pan_head_m3_10mm.dxf, baut_pan_head_m3_10mm.stl, dinding_belakang.dxf, dinding_depan.dxf, dinding_sisi_kanan.dxf, dinding_sisi_kiri.dxf, modul_sensor_mq2.stl, modul_sensor_mq7.stl]
2026-11-10 fix(hardware): implement I2C bus recovery, auto-healing OLED, silent POST, and 15s warmup shield
    [prodC3.ino]
2026-11-10 docs(whiteboard): record TD-H09 I2C bus recovery and silent POST implementation
2026-11-10 refactor(firmware): support dual Arduino IDE and PlatformIO via prodC3/prodC3.ino
2026-11-10 fix(firmware): fan power sequencing, 50-75-100% curve, and active OLED I2C heartbeat
    [prodC3.ino]
